frascella-dev/tdm-dash/design/index.html

Design proposal · milestone M1

# tdm-dash dashboard

The digital dashboard for the '92 Yamaha TDM 850, simulated at true 800×480 with the same measurements, the same filters and the same warnings that the Rust software will use. Use MODE and SET as on the bike.

- 7″ IPS
- 800×480 · 133 ppi
- 1000 cd/m²
- Pi Zero 2 W + Pico

MODE SET

## Riding layout

Classic Sport Touring

## Screen

On the bike: a short MODE changes screen, a long SET when stopped opens the settings.

## Scenario

Pause

×1 ×2 ×4

Turn the key (full restart)

## Ambient light

nighttunnelcloudysun

Auto Day Night

## Faults to try

Unplug the USB Freeze the app

They show the "fail-dark" behavior: better a black screen than stale data.

## Scale

Fit 1:1 pixel Real

"Real" shows the 154 × 86 mm of the active area on a 96 dpi screen.

M MODE · S SET (hold ≥ 1 s for a long press) · ← → turn signals · H high beam · 123 layout · Space pause

## Speed: true, measured and shown · last 12 s

- true
- measured by the Pico (windows over whole wheel revolutions)
- shown (filter, +3 % +1 km/h, hysteresis)

## Display

Model

Newhaven NHD-7.0-800480AF-ASXP

Diagonal

7″ · 133 ppi

Active area

154.2 × 85.6 mm

Outline

165 × 104 mm

Resolution

800 × 480, 18-bit RGB over DPI

Brightness

1000 cd/m², IPS

Temperature

−20 … +70 °C

Backlight

180 mA at 9.3 V · TPS61169, PWM from the Pico

Boot

< 4 s from key to first frame

## Rules for Slint

- No rotation except the needles, drawn as Paths with the points computed in Rust.
- Dials, glows and gradients pre-rendered at startup (tiny-skia) as opaque images.
- Rpm bars: pre-rendered image revealed by a clip rectangle.
- Digits in fixed-width cells: the numbers do not "jump" when they change.
- Sport speed ≥ 140 px high (≈ 27 mm on the 7″); daytime contrast ≥ 7:1.
- Warning lights in ECE colors: green turn signals and neutral, blue high beam, amber caution, red critical.
- No animations while riding, except warnings and the shift light.

## Palette

Typography: Saira Semi Condensed (OFL) for the dashboard digits and text.

Open-source project frascella-dev/tdm-dash (https://github.com/frascella-dev/tdm-dash) · design proposal for milestone M1 · the bike values are a draft until the bike measurements.
