frascella-dev/tdm-dash/hardware/exports/drawings/fit-template.pdf

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
A | A
B | B
C | C
D | D

SCALE
1:1

REV
0.2

DATE
2026-10-21

SIZE
A4

## Fit template

tdm-dash | mechanical parts · Yamaha TDM 850 (3VD) | CERN-OHL-P-2.0

github.com/frascella-dev/tdm-dash · generated by hardware/drawings/generate.py from hardware/enclosure/enclosure.scad, do not edit by hand

213.8

150

40

## FIT TEMPLATE · seen from the rider

cut along the thick line, pierce the two crosses

0 | 10 | 20 | 30 | 40 | 50 mm

Print at 100 % (actual size): this bar measures 50 mm

NOTES
1. Print at 100 %: the bar measures 50 mm and the width 213.8 mm. Glue on cardboard and cut along the thick line.
2. Hold it where the original cluster was, the face towards the rider. It must clear the windscreen, the inner fairing panels and the ignition key with the handlebar at full lock on both sides.
3. The crosses are the M6 studs of the mount plate: they must fall on the grommets of the fairing stay. If not, measure the grommets from the center lines and set stud_pitch, stud_x and stud_y in enclosure.scad.
4. Dashed: the pod and the mount plate, behind the display unit. Depth behind the face: 14.5 mm display unit, 65.6 mm with the pod, 68.6 mm with the plate.
