frascella-dev/tdm-dash/hardware/exports/drawings/sensor-bracket.pdf

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
A | A
B | B
C | C
D | D

SCALE
1:1

REV
0.2

DATE
2026-10-21

SIZE
A4

## Sensor bracket

tdm-dash | mechanical parts · Yamaha TDM 850 (3VD) | CERN-OHL-P-2.0

github.com/frascella-dev/tdm-dash · generated by hardware/drawings/generate.py from hardware/bracket/sensor-bracket.scad, do not edit by hand

83

48

8
35°

2× Ø10.5

slot 12.3 wide

3

Plate 3 mm, aluminum 5754 or 6082

0 | 10 | 20 | 30 | 40 | 50 mm

Print at 100 % (actual size): this bar measures 50 mm

NOTES
1. Print the PDF at 100 % (actual size) on A4 landscape and check the 50 mm bar.
2. Glue the print on the plate, center-punch the crossings of the center lines, drill the holes, then cut and file the outline.
3. Only aluminum may go under a brake caliper bolt. A printed bracket is a fit check, never a part (chapter 07).
4. The sensor slides in the slot: 48 ± 4 mm from the bolt. Its two M12 nuts set the 1–2 mm gap to the disc bolts.
5. Dimensions in mm, from sensor-bracket.scad. Orange values are [TO VERIFY] on the bike (docs/research/bike-measurements.md): set them in the .scad file and regenerate.
