frascella-dev/tdm-dash/design/screenshots/15-warm-up.png

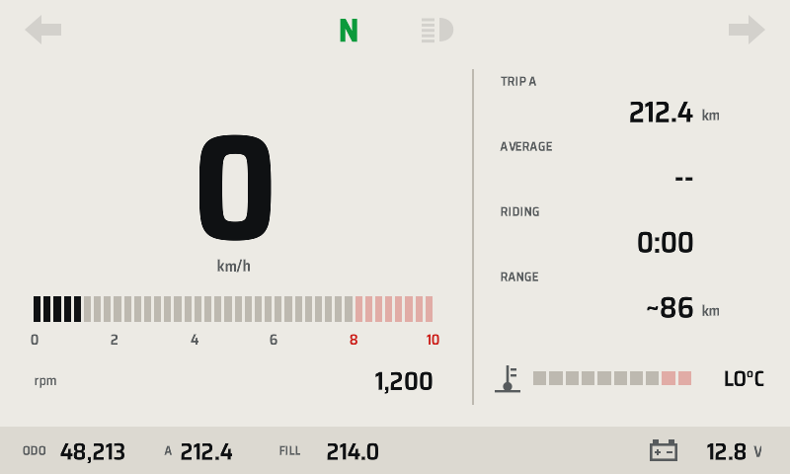
design/screenshots/15-warm-up.png
