frascella-dev/tdm-dash/design/screenshots/400x1280-r90/03-classic-day.png

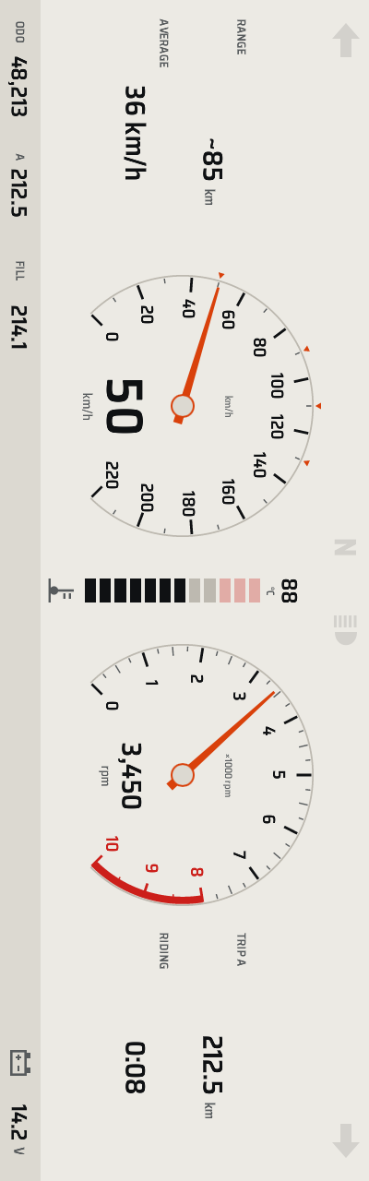
design/screenshots/400x1280-r90/03-classic-day.png
