frascella-dev/tdm-dash/design/screenshots/400x1280-r90/13-warning-critical.png

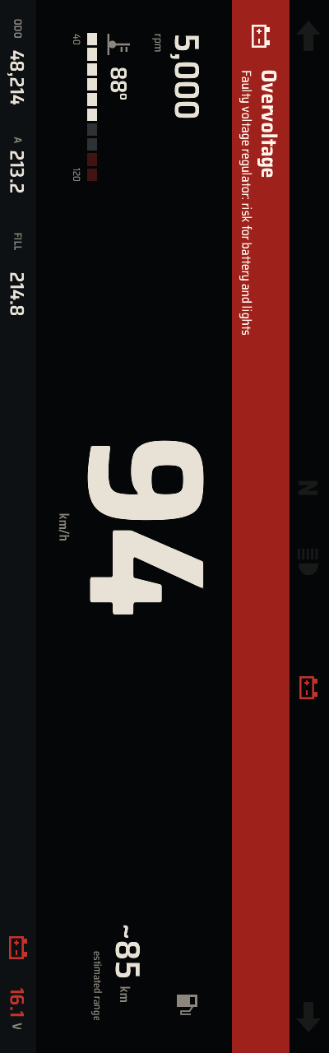
design/screenshots/400x1280-r90/13-warning-critical.png
