frascella-dev/tdm-dash/design/screenshots/1024x600/04-classic-night.png

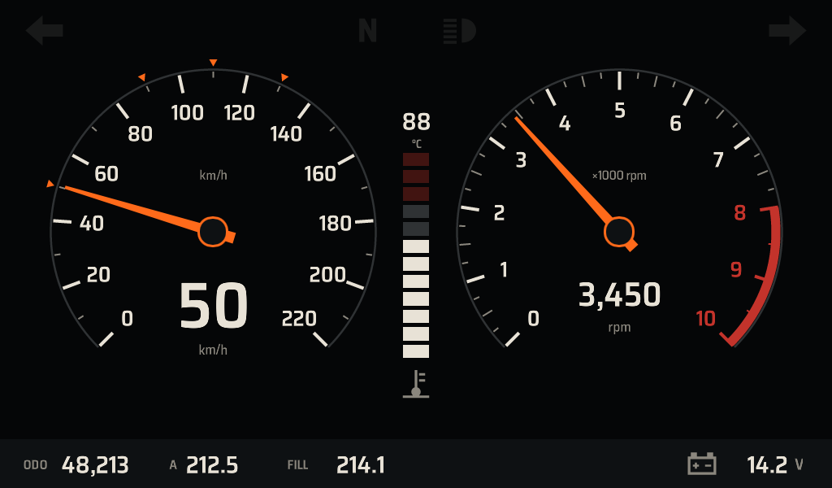
design/screenshots/1024x600/04-classic-night.png
