frascella-dev/tdm-dash/design/screenshots/1024x600/05-sport-day.png

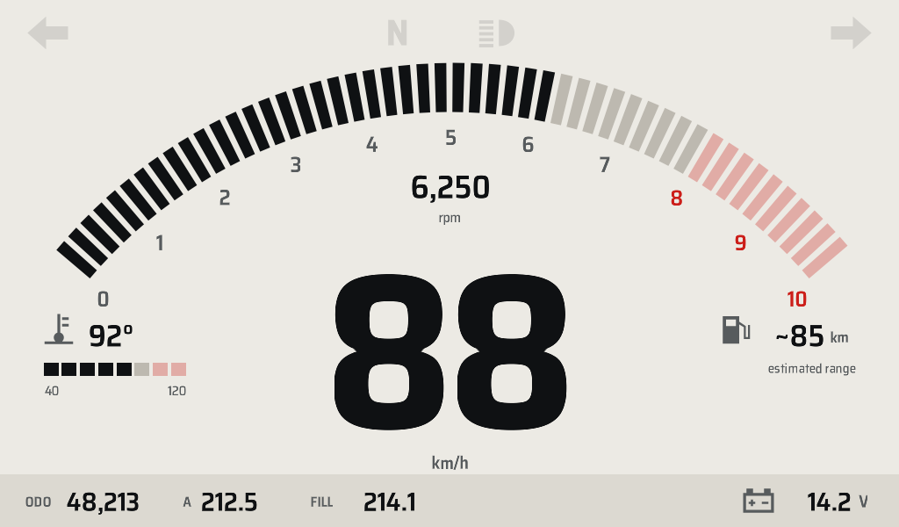
design/screenshots/1024x600/05-sport-day.png
