frascella-dev/tdm-dash/design/screenshots/1024x600/07-touring-day.png

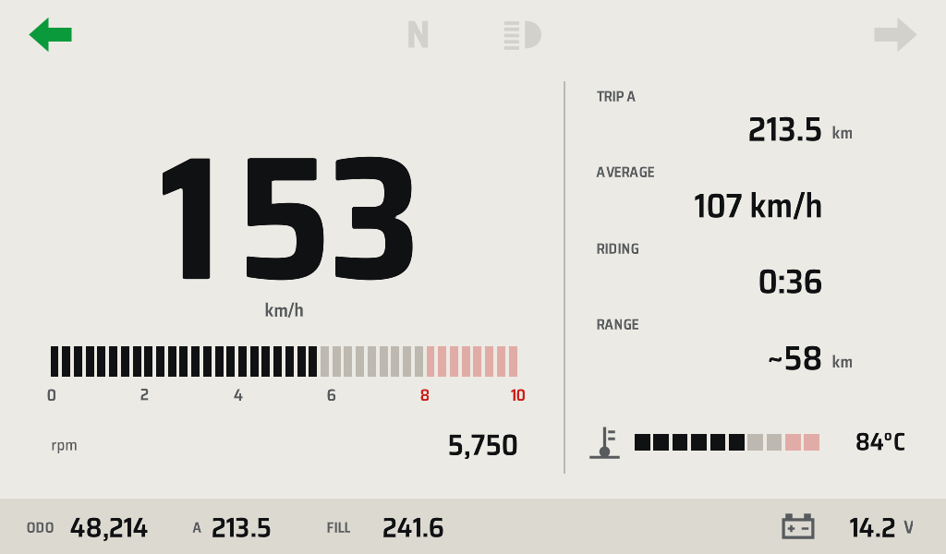
design/screenshots/1024x600/07-touring-day.png
