frascella-dev/tdm-dash/design/screenshots/1024x600/09-trip.png

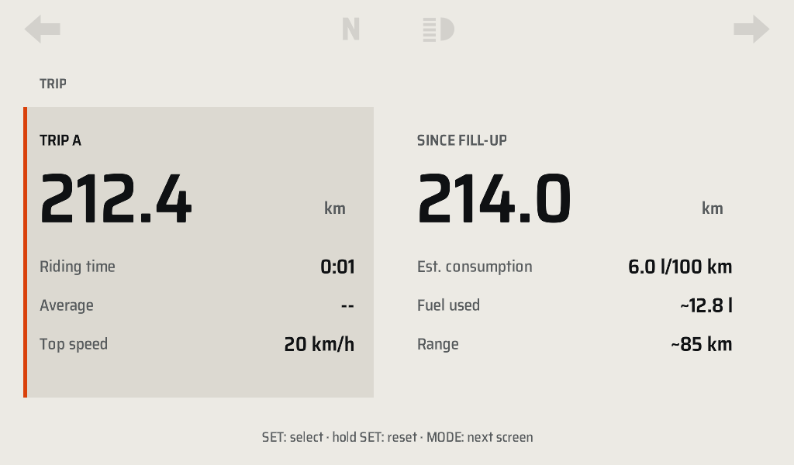
design/screenshots/1024x600/09-trip.png
