frascella-dev/tdm-dash/design/screenshots/1024x600/10-diagnostics.png

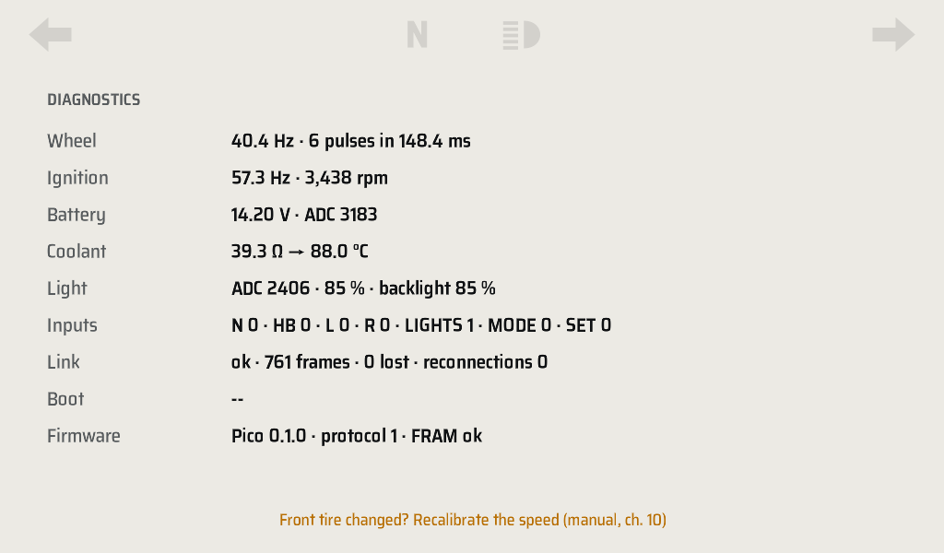
design/screenshots/1024x600/10-diagnostics.png
