frascella-dev/tdm-dash/design/screenshots/1024x600/11-settings.png

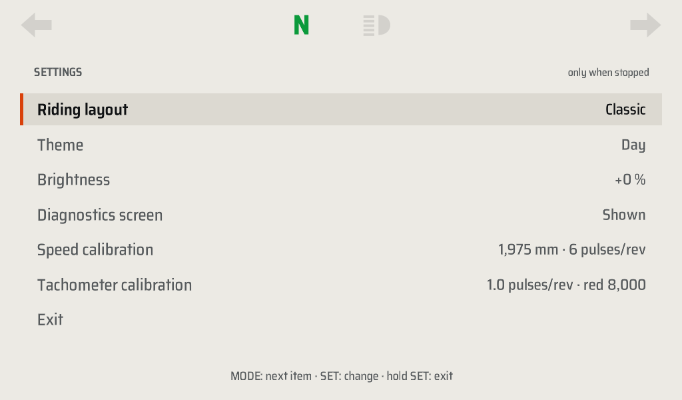
design/screenshots/1024x600/11-settings.png
