frascella-dev/tdm-dash/design/screenshots/1024x600/12-warning-caution.png

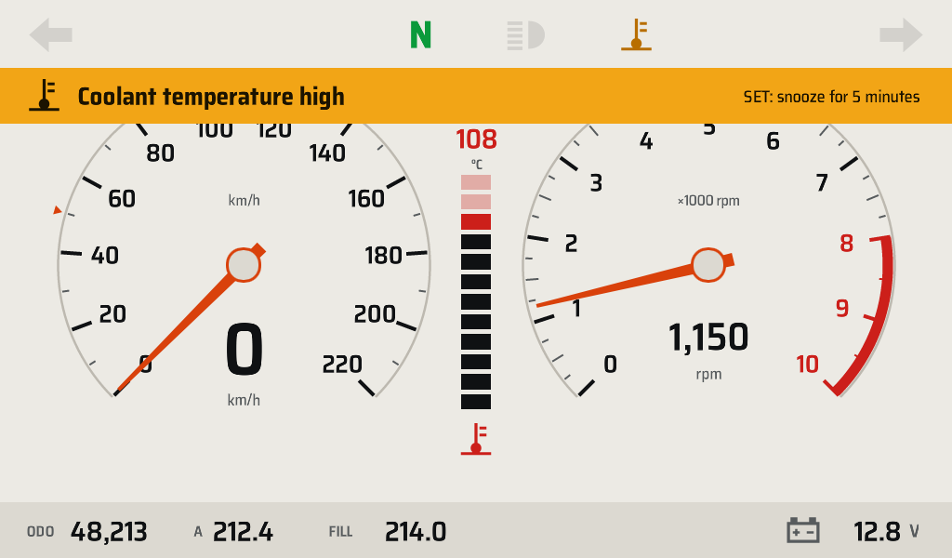
design/screenshots/1024x600/12-warning-caution.png
