frascella-dev/tdm-dash/design/screenshots/1024x600/13-warning-critical.png

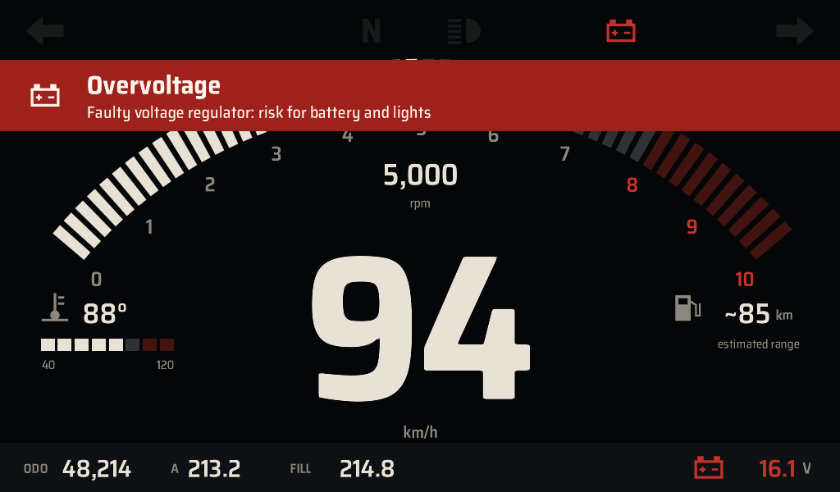
design/screenshots/1024x600/13-warning-critical.png
