frascella-dev/tdm-dash/design/screenshots/1280x400/03-classic-day.png

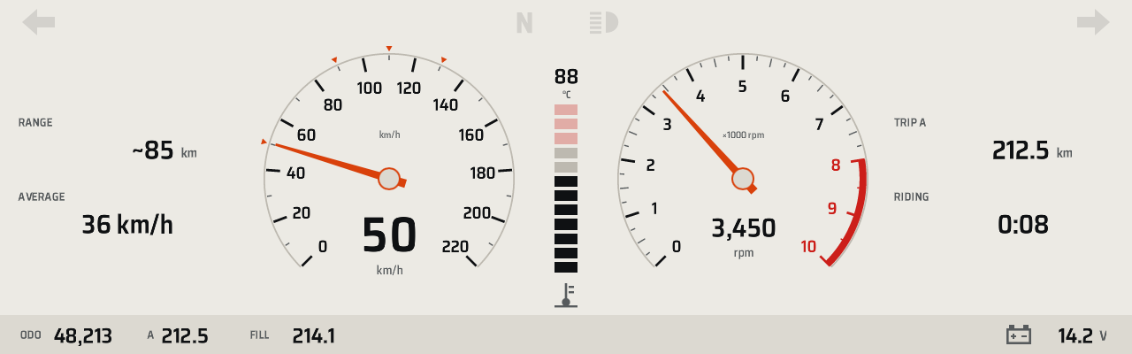
design/screenshots/1280x400/03-classic-day.png
