frascella-dev/tdm-dash/design/screenshots/1280x400/04-classic-night.png

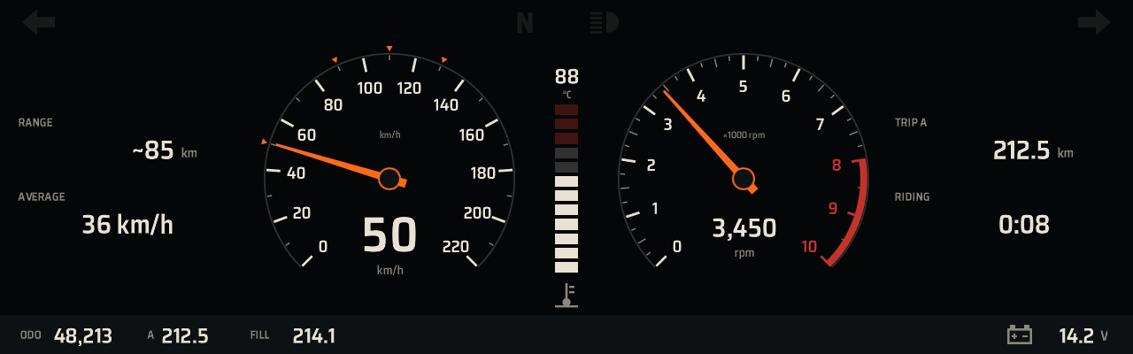
design/screenshots/1280x400/04-classic-night.png
