frascella-dev/tdm-dash/design/screenshots/1280x400/06-sport-night.png

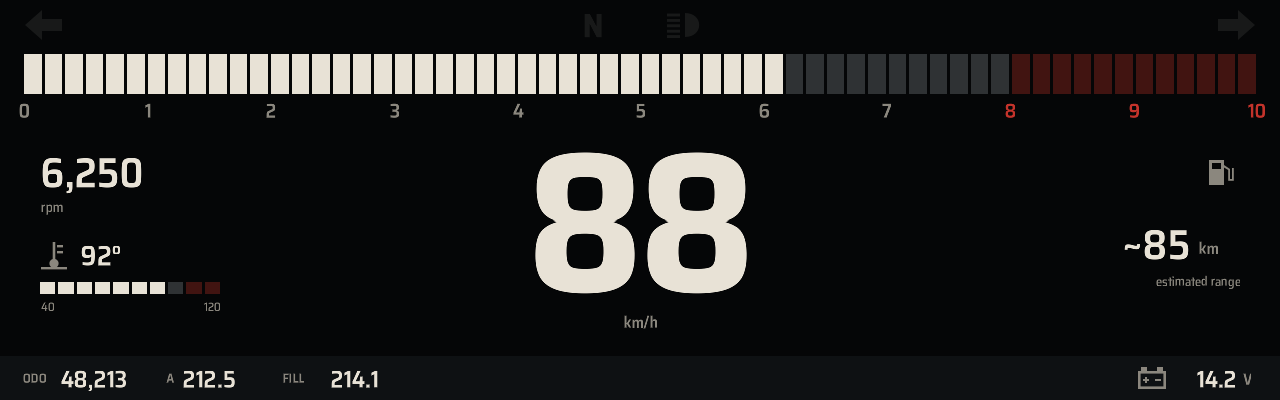
design/screenshots/1280x400/06-sport-night.png
