frascella-dev/tdm-dash/design/screenshots/1280x400/07-touring-day.png

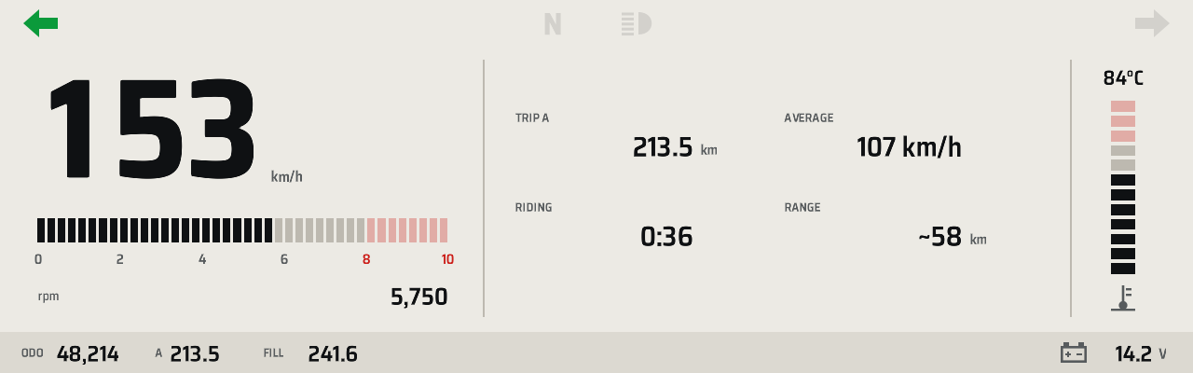
design/screenshots/1280x400/07-touring-day.png
