frascella-dev/tdm-dash/design/screenshots/1280x400/08-touring-night.png

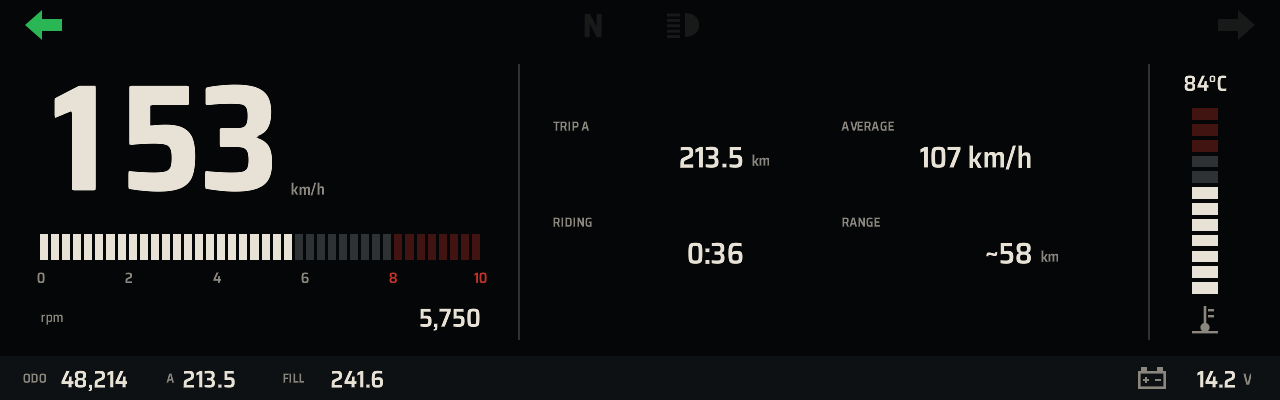
design/screenshots/1280x400/08-touring-night.png
