frascella-dev/tdm-dash/design/screenshots/1280x400/09-trip.png

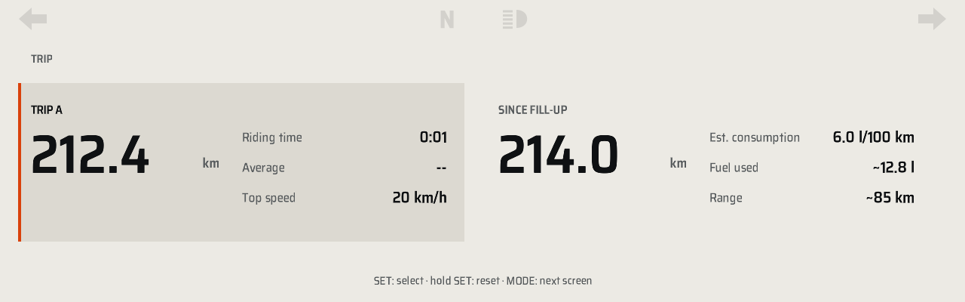
design/screenshots/1280x400/09-trip.png
