frascella-dev/tdm-dash/design/screenshots/1280x400/10-diagnostics.png

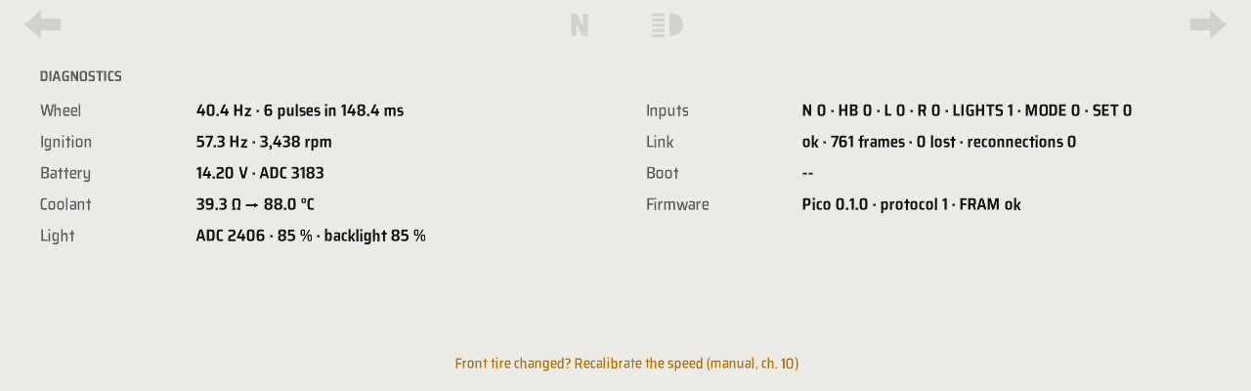
design/screenshots/1280x400/10-diagnostics.png
