frascella-dev/tdm-dash/design/screenshots/1280x400/11-settings.png

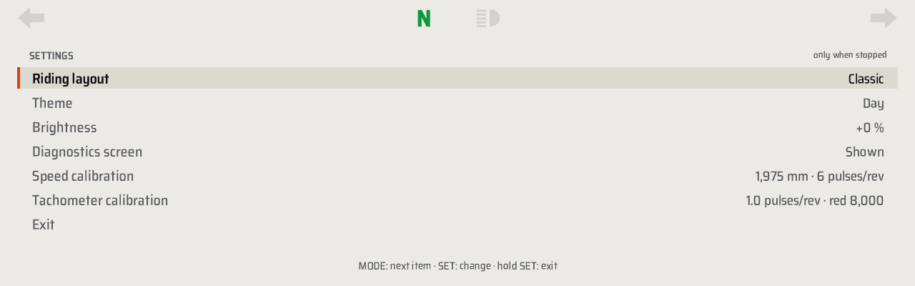
design/screenshots/1280x400/11-settings.png
