frascella-dev/tdm-dash/design/screenshots/1280x400/12-warning-caution.png

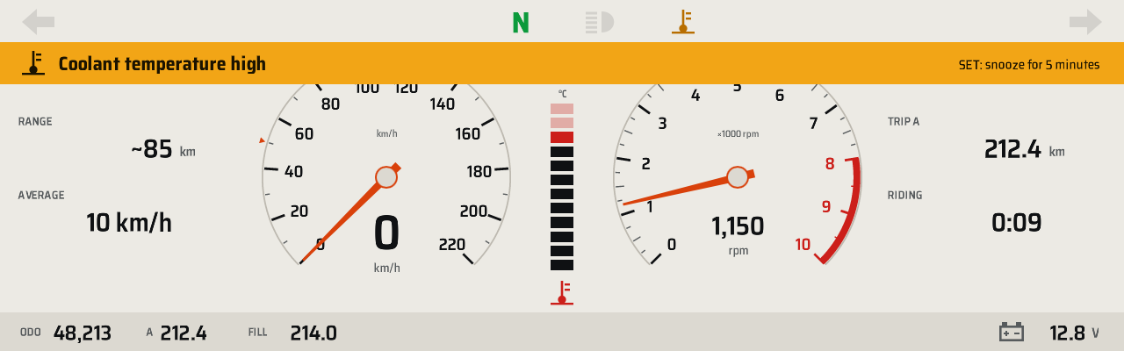
design/screenshots/1280x400/12-warning-caution.png
