frascella-dev/tdm-dash/design/screenshots/1280x400/13-warning-critical.png

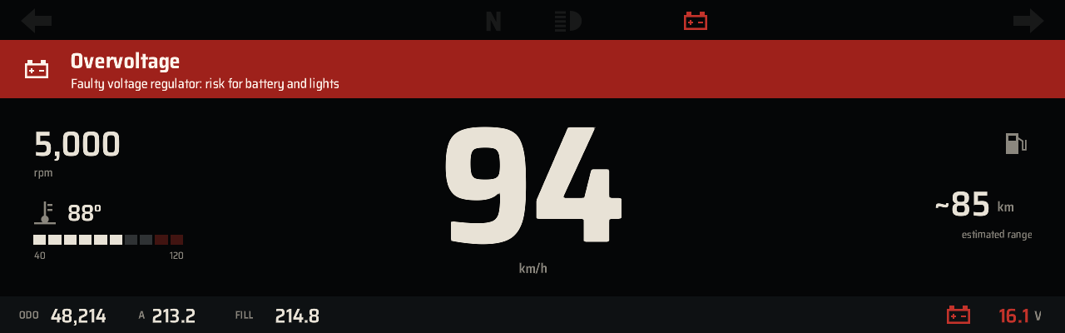
design/screenshots/1280x400/13-warning-critical.png
