frascella-dev/tdm-dash/design/screenshots/1280x400/14-usb-lost.png

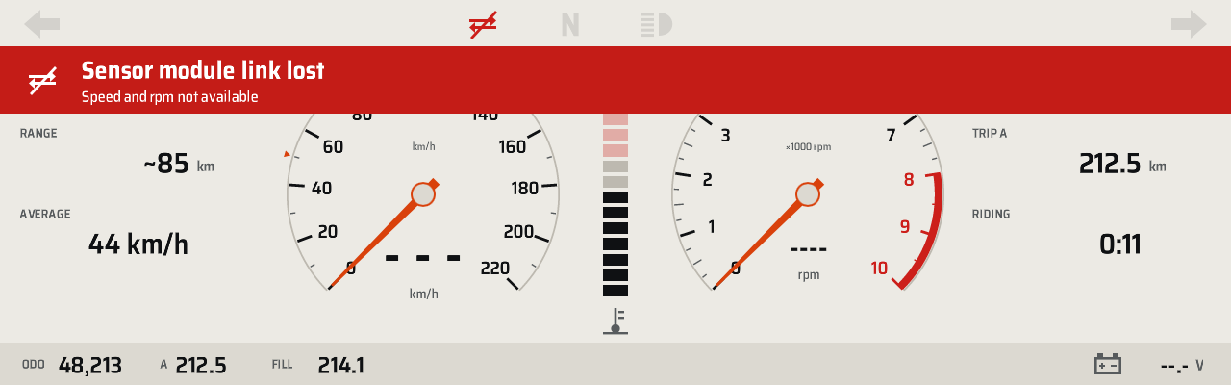
design/screenshots/1280x400/14-usb-lost.png
