frascella-dev/tdm-dash/design/screenshots/1280x720/03-classic-day.png

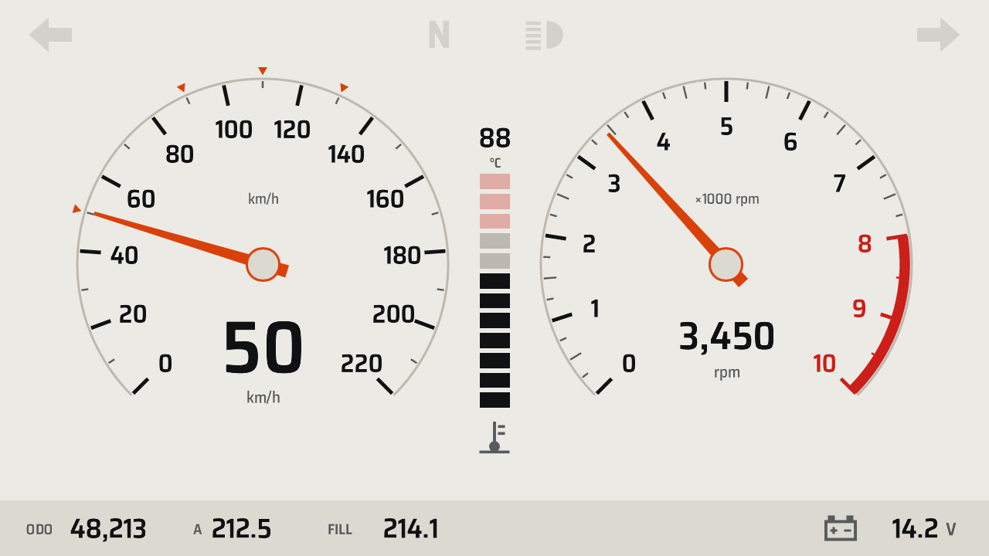
design/screenshots/1280x720/03-classic-day.png
