frascella-dev/tdm-dash/design/screenshots/1280x720/05-sport-day.png

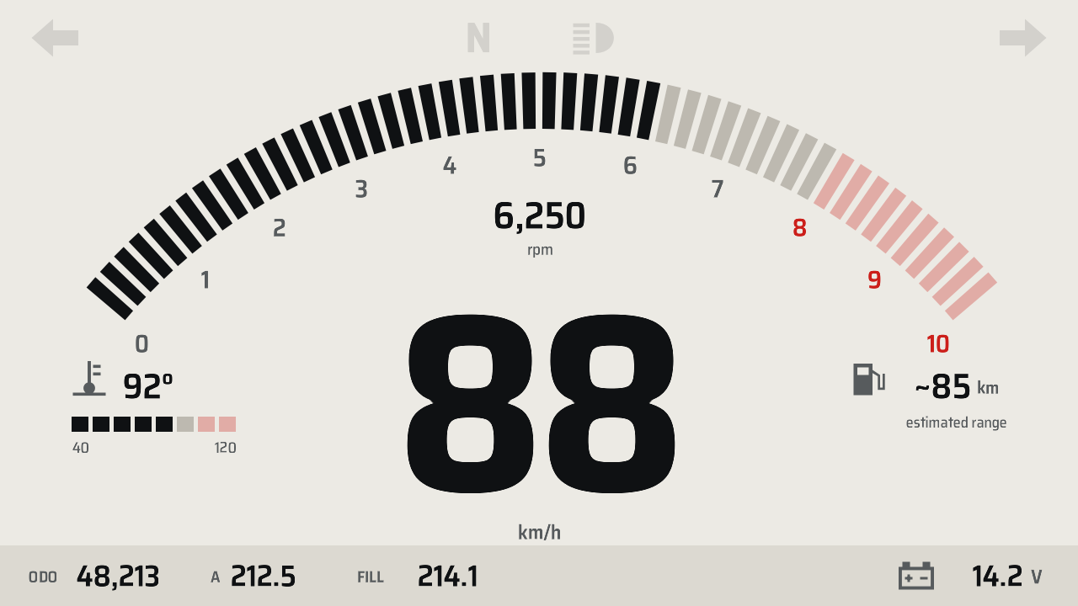
design/screenshots/1280x720/05-sport-day.png
