frascella-dev/tdm-dash/design/screenshots/1280x720/07-touring-day.png

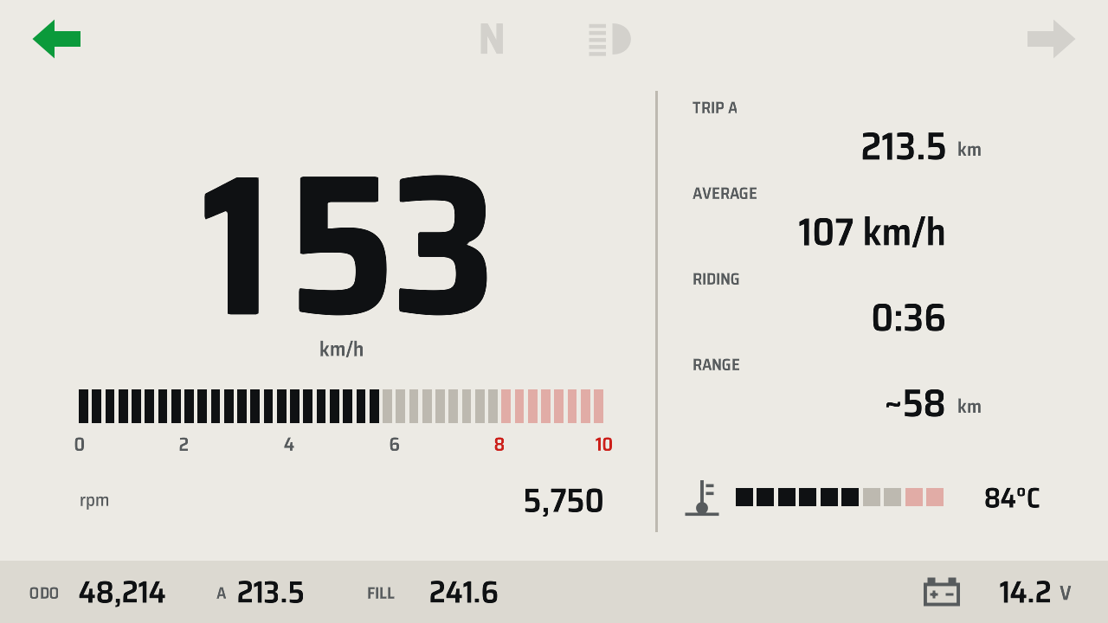
design/screenshots/1280x720/07-touring-day.png
