frascella-dev/tdm-dash/design/screenshots/1280x720/10-diagnostics.png

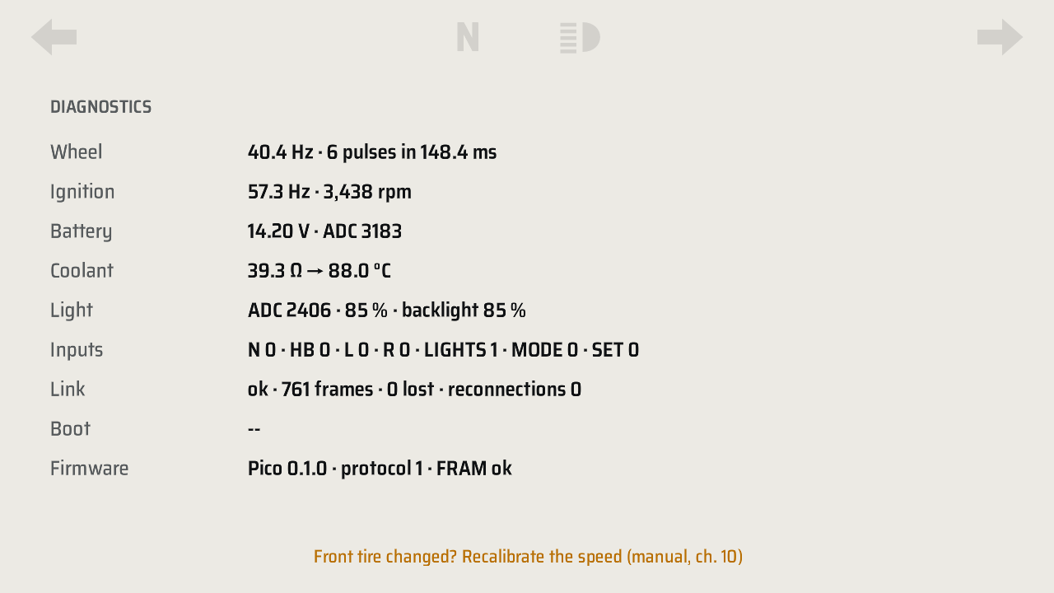
design/screenshots/1280x720/10-diagnostics.png
