frascella-dev/tdm-dash/design/screenshots/1920x480/03-classic-day.png

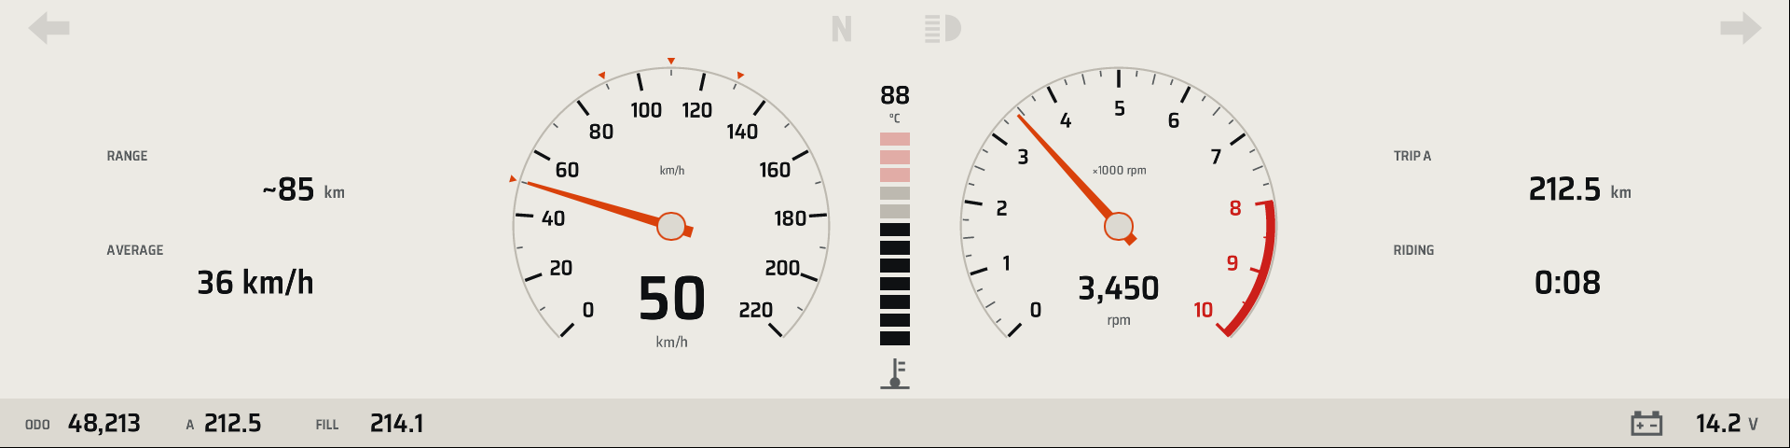
design/screenshots/1920x480/03-classic-day.png
