frascella-dev/tdm-dash/design/screenshots/1920x480/04-classic-night.png

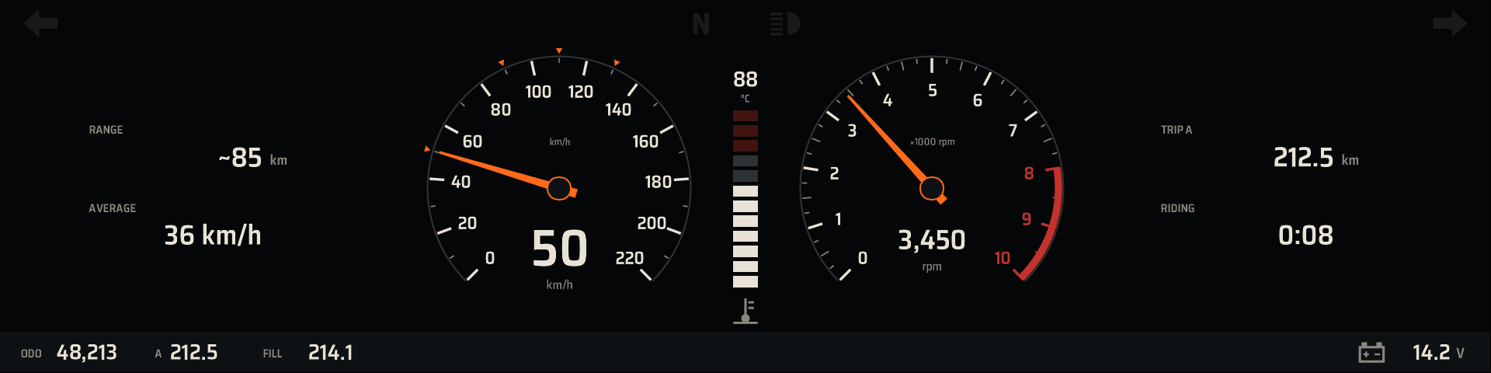
design/screenshots/1920x480/04-classic-night.png
