frascella-dev/tdm-dash/design/screenshots/1920x480/07-touring-day.png

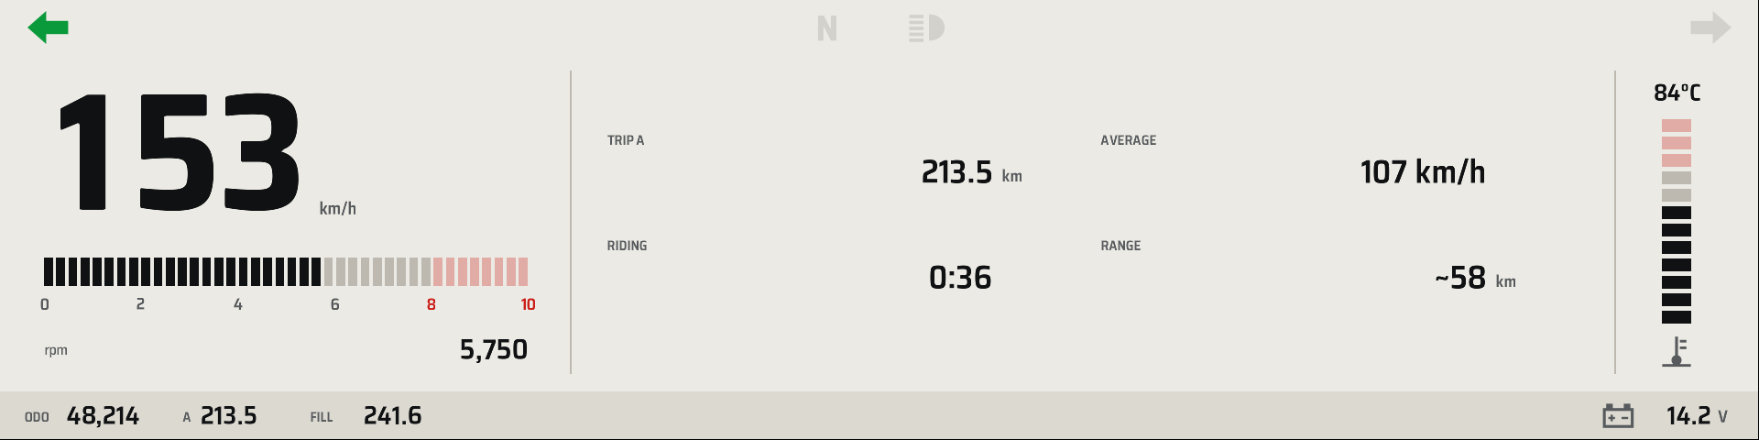
design/screenshots/1920x480/07-touring-day.png
