frascella-dev/tdm-dash/design/screenshots/1920x480/10-diagnostics.png

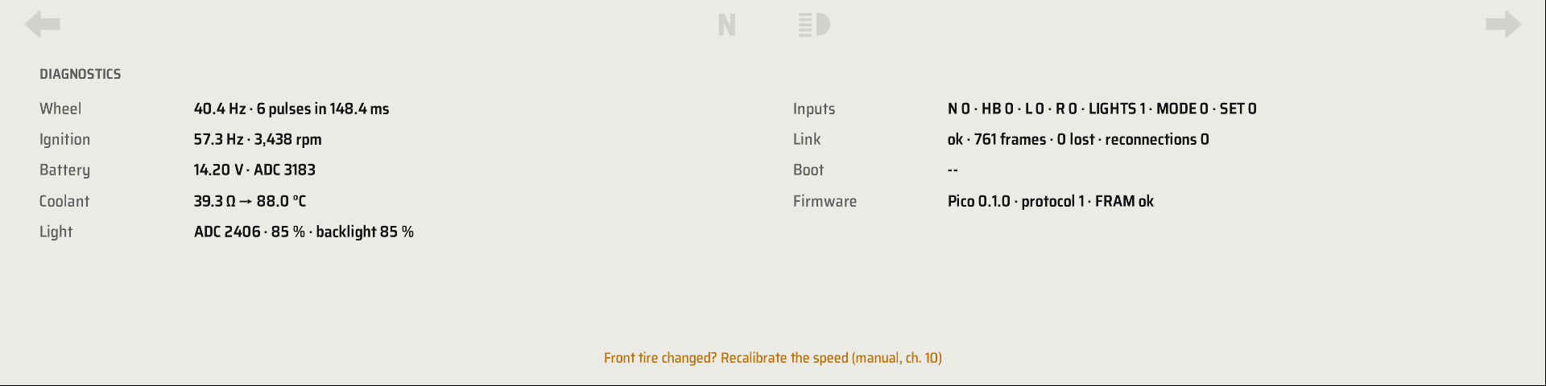
design/screenshots/1920x480/10-diagnostics.png
