frascella-dev/tdm-dash/design/screenshots/1920x720/03-classic-day.png

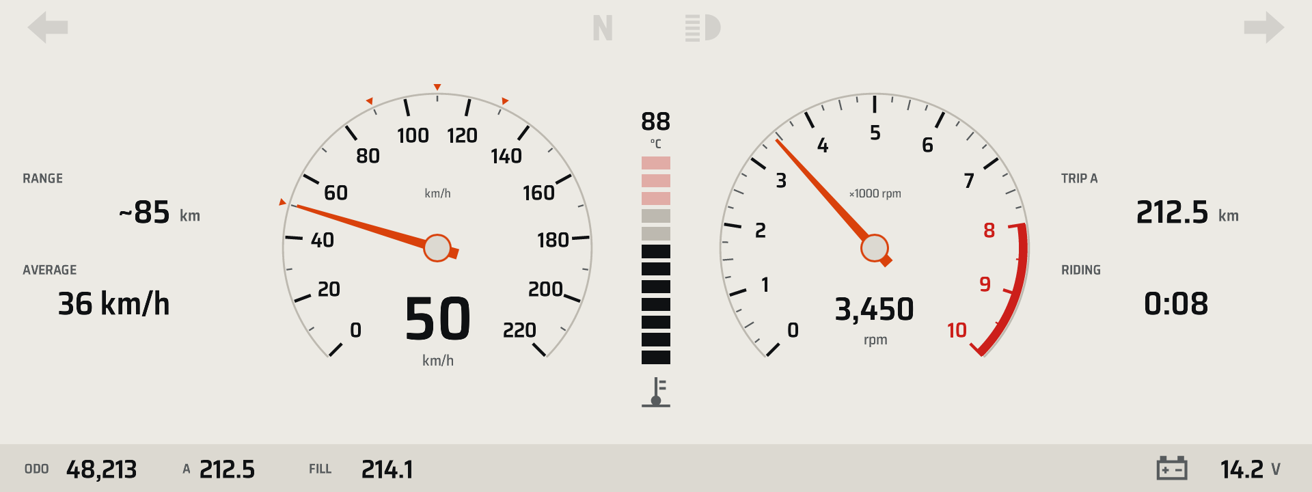
design/screenshots/1920x720/03-classic-day.png
