frascella-dev/tdm-dash/design/screenshots/1920x720/04-classic-night.png

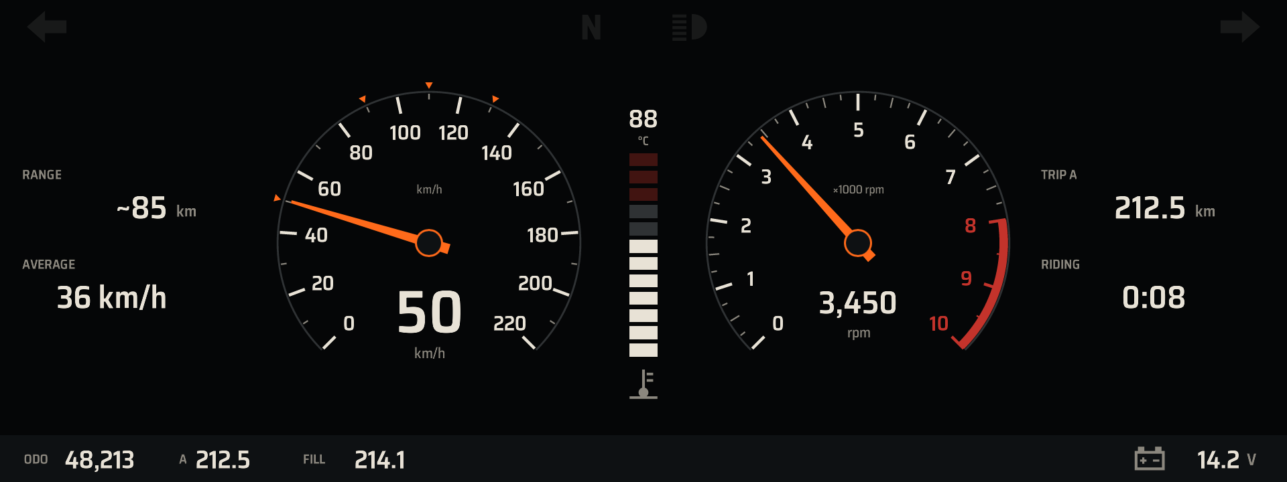
design/screenshots/1920x720/04-classic-night.png
