frascella-dev/tdm-dash/design/screenshots/1920x720/12-warning-caution.png

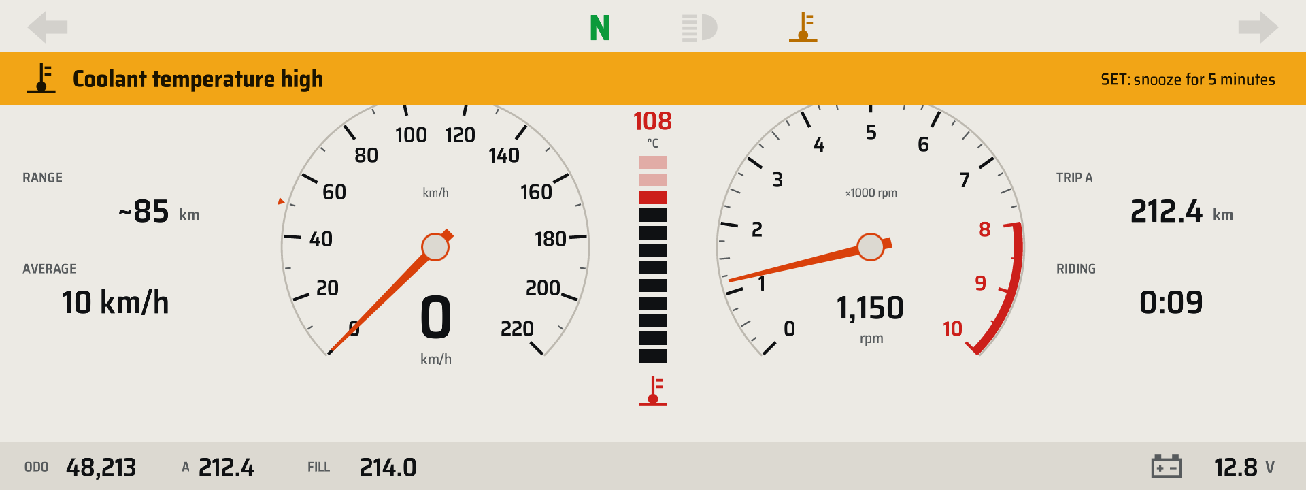
design/screenshots/1920x720/12-warning-caution.png
