frascella-dev/tdm-dash/design/screenshots/it-07-touring-day.png

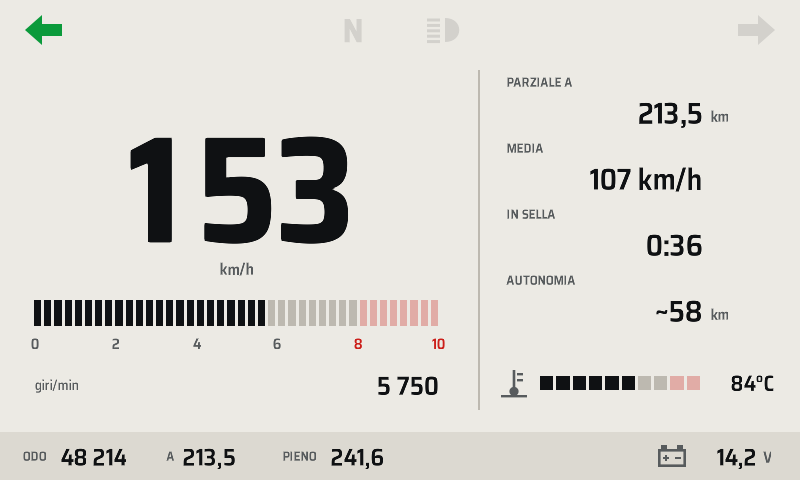
design/screenshots/it-07-touring-day.png
