frascella-dev/tdm-dash/design/screenshots/it-09-trip.png

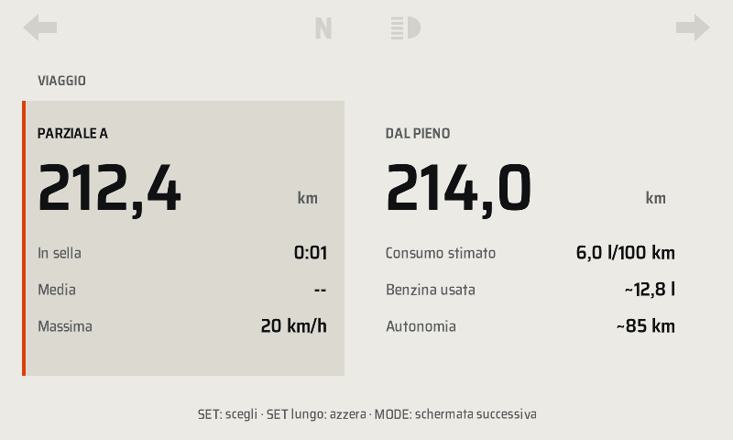
design/screenshots/it-09-trip.png
