frascella-dev/tdm-dash/design/screenshots/it-10-diagnostics.png

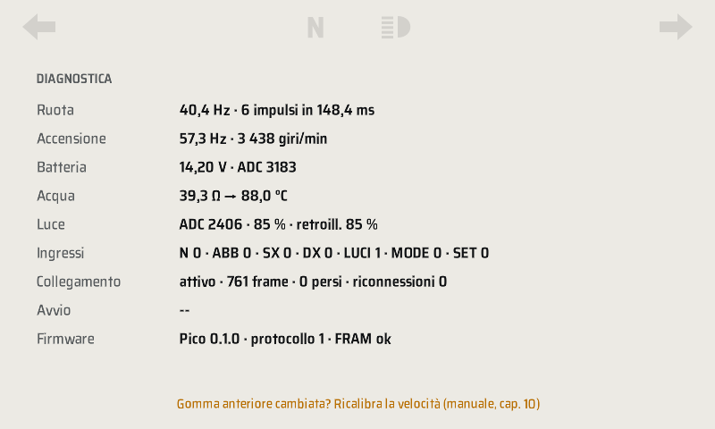
design/screenshots/it-10-diagnostics.png
