frascella-dev/tdm-dash/design/screenshots/it-11-settings.png

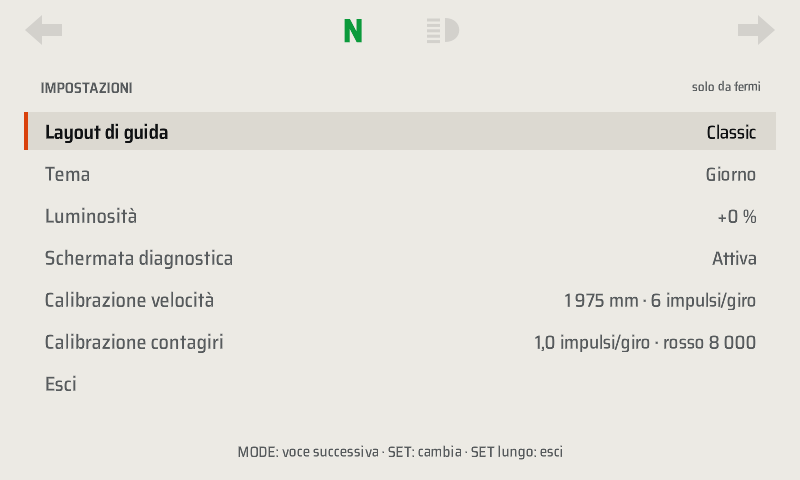
design/screenshots/it-11-settings.png
