frascella-dev/tdm-dash/hardware/exports/harness/backlight.bom.tsv

Id | Description | Qty | Unit | Designators
1 | Cable, Lead, 3 x 0.25 mm² | 0.15 | m | W1
2 | Cable, Pair, 2 x 0.25 mm² | 0.1 | m | W2
3 | Connector, Panel backlight LEDs, on the Kippah [TO VERIFY], 2 pins | 1 |  | J704
4 | Connector, TPS61169 breakout, pin order [TO VERIFY], 5 pins | 1 |  | U701
5 | Connector, Terminal on the perfboard, 3 pins | 1 |  | J701
