frascella-dev/tdm-dash/hardware/exports/harness/panel.bom.tsv

Id | Description | Qty | Unit | Designators
1 | Cable, Lead, 3 x 0.14 mm² | 0.1 | m | W2
2 | Cable, Lead, 4 x 0.25 mm² | 0.15 | m | W1
3 | Connector, IP67 push button, MODE, momentary NO, 2 pins | 1 |  | SW601
4 | Connector, IP67 push button, SET, momentary NO, 2 pins | 1 |  | SW602
5 | Connector, TEMT6000 (breakout), behind the light hole, 3 pins | 1 |  | U1
6 | Connector, Terminal on the perfboard, 3 pins | 2 |  | J501, J601
