frascella-dev/tdm-dash/hardware/exports/harness/wheel-sensor.bom.tsv

Id | Description | Qty | Unit | Designators
1 | Cable, Sensor cable, 3 x 0.34 mm² | 1 | m | W1
2 | Cable, Shielded 3-core cable, 3 x 0.34 mm² shielded | 1.2 | m | W2
3 | Connector, Deutsch DTM04-3P, male, mates X2, 3 pins | 1 |  | X1
4 | Connector, Deutsch DTM06-3S + W3S, female, mates X1, 3 pins | 1 |  | X2
5 | Connector, LJ12A3-4-Z/BX, inductive NPN NO, 6–36 V, 3 pins | 1 |  | S1
6 | Connector, Terminal on the perfboard, 3 pins | 1 |  | J401
