frascella-dev/tdm-dash/hardware/exports/cad/dash-mount.stl

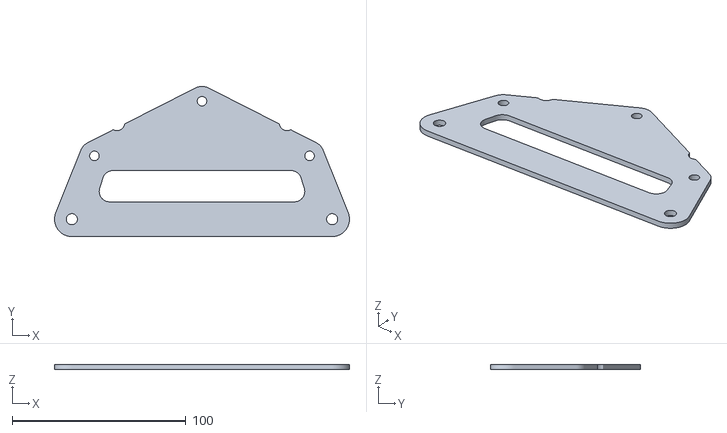
[picture p49: CAD file, 2026-10-21]
hardware/exports/cad/dash-mount.stl
170.0 x 86.5 x 3.00
