frascella-dev/tdm-dash/hardware/exports/cad/enclosure-front.stl

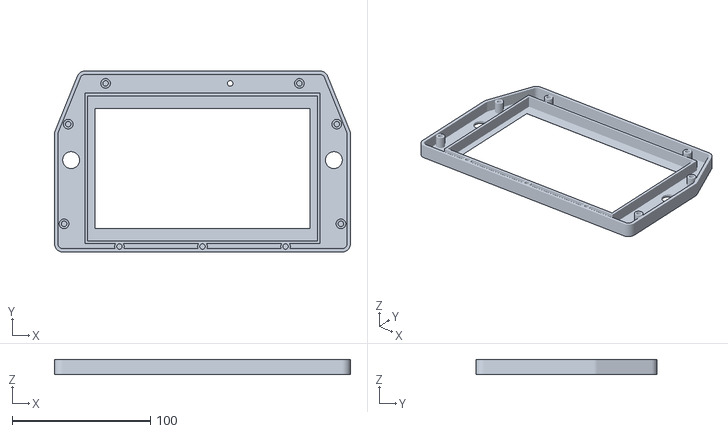
[picture p50: CAD file, 2026-10-21]
hardware/exports/cad/enclosure-front.stl
213.8 x 130.8 x 11.0
