frascella-dev/tdm-dash/hardware/exports/cad/enclosure-rear.stl

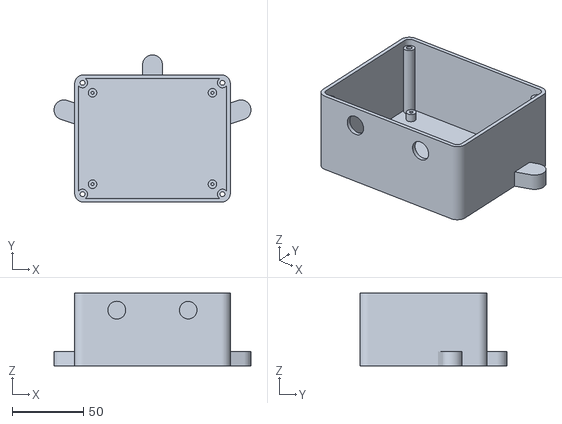
[picture p51: CAD file, 2026-10-21]
hardware/exports/cad/enclosure-rear.stl
138.0 x 103.0 x 51.1
