frascella-dev/tdm-dash/hardware/exports/cad/enclosure-cover.stl

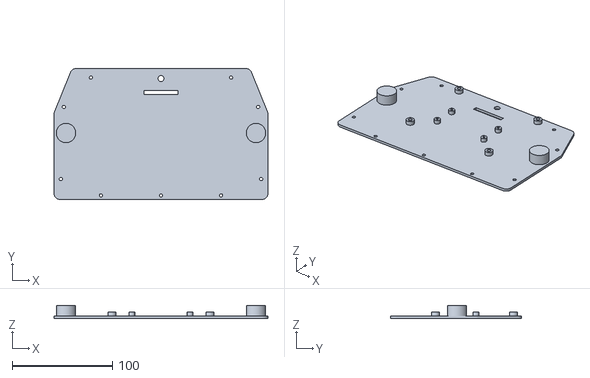
[picture p52: CAD file, 2026-10-21]
hardware/exports/cad/enclosure-cover.stl
213.8 x 130.8 x 13.0
