frascella-dev/tdm-dash/hardware/exports/cad/sensor-bracket.stl

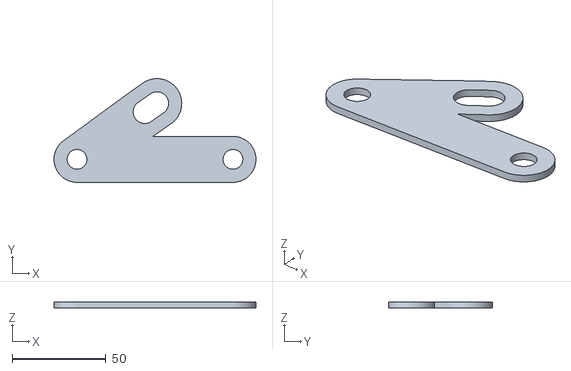
[picture p53: CAD file, 2026-10-21]
hardware/exports/cad/sensor-bracket.stl
107.5 x 55.2 x 3.00
