frascella-dev/tdm-dash/(list of files, cad)

Other CAD files:
hardware/exports/cad/dash-mount.dxf
hardware/exports/cad/sensor-bracket.dxf
