frascella-dev/tdm-dash/hardware/exports/drawings/dash-mount.pdf

124

4× R4.5

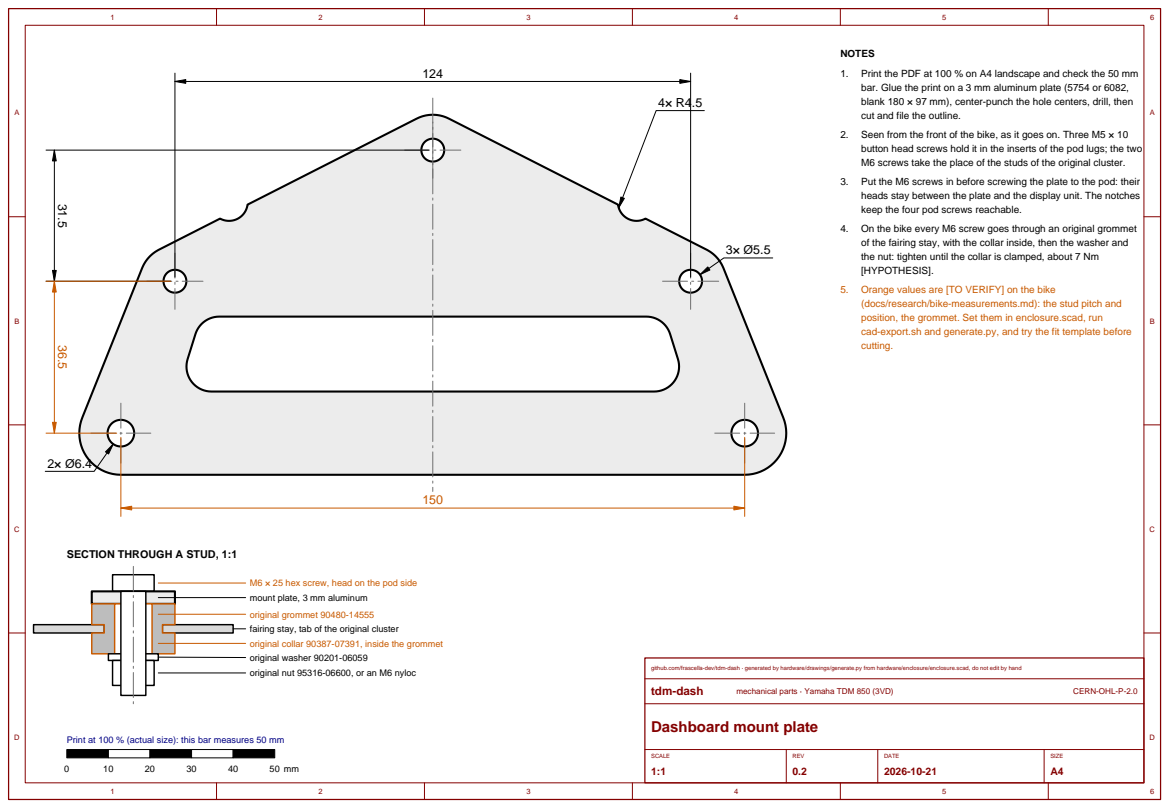
[picture p71: page 1]
SCALE 1:1; REV 0.2; DATE 2026-10-21; SIZE A4; tdm-dash; mechanical parts · Yamaha TDM 850 (3VD); CERN-OHL-P-2.0

NOTES
1. Print the PDF at 100 % on A4 landscape and check the 50 mm
bar. Glue the print on a 3 mm aluminum plate (5754 or 6082,
blank 180 × 97 mm), center-punch the hole centers, drill, then
cut and file the outline.
2. Seen from the front of the bike, as it goes on. Three M5 × 10
button head screws hold it in the inserts of the pod lugs; the two
M6 screws take the place of the studs of the original cluster.
3. Put the M6 screws in before screwing the plate to the pod: their
heads stay between the plate and the display unit. The notches
keep the four pod screws reachable.
4. On the bike every M6 screw goes through an original grommet
of the fairing stay, with the collar inside, then the washer and
the nut: tighten until the collar is clamped, about 7 Nm
[HYPOTHESIS].
5. Orange values are [TO VERIFY] on the bike
(docs/research/bike-measurements.md): the stud pitch and
position, the grommet. Set them in enclosure.scad, run
cad-export.sh and generate.py, and try the fit template before
cutting.

SECTION THROUGH A STUD, 1:1

M6 × 25 hex screw, head on the pod side
mount plate, 3 mm aluminum
original grommet 90480-14555
fairing stay, tab of the original cluster
original collar 90387-07391, inside the grommet
original washer 90201-06059
original nut 95316-06600, or an M6 nyloc

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

Dashboard mount plate

Print at 100 % (actual size): this bar measures 50 mm
