frascella-dev/tdm-dash/hardware/exports/drawings/enclosure.pdf

213.8

### window 159.2

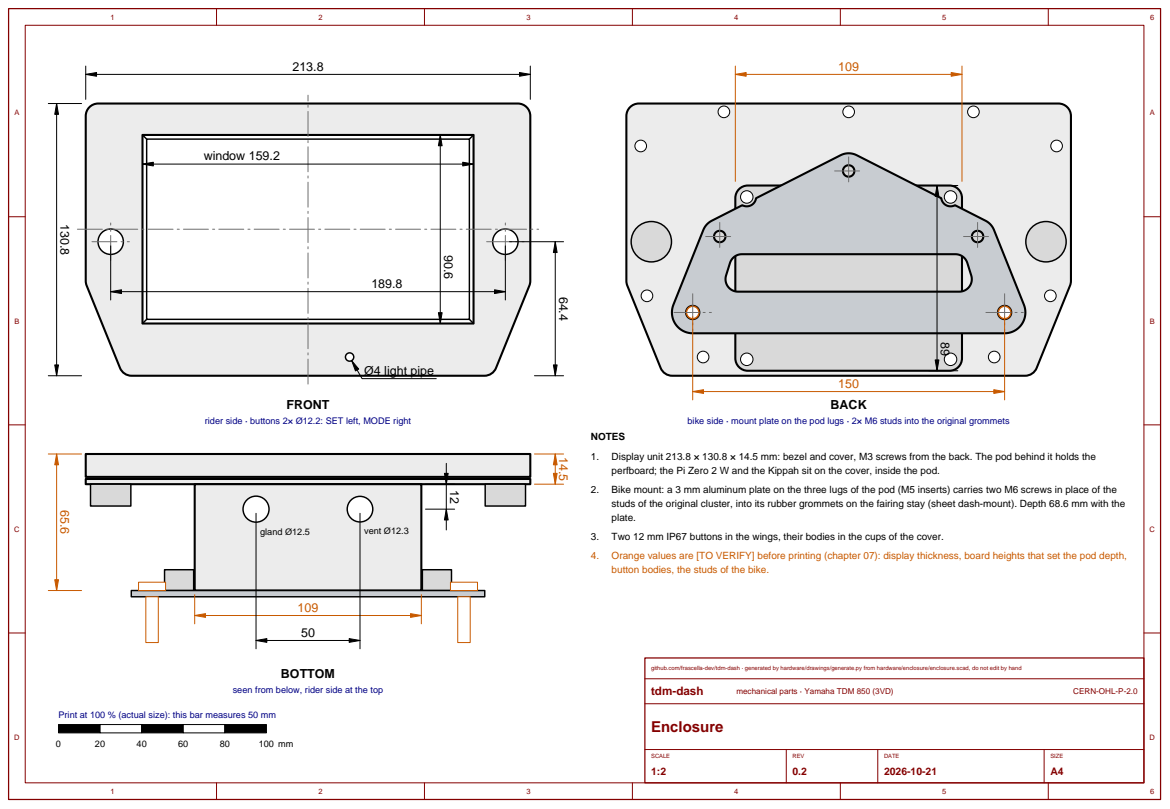
[picture p72: page 1]
SCALE 1:2; REV 0.2; DATE 2026-10-21; SIZE A4; Enclosure; tdm-dash; mechanical parts · Yamaha TDM 850 (3VD); CERN-OHL-P-2.0; Ø4 light pipe; FRONT; BACK; gland Ø12.5; vent Ø12.3; BOTTOM

rider side · buttons 2× Ø12.2: SET left, MODE right

bike side · mount plate on the pod lugs · 2× M6 studs into the original grommets

NOTES
1. Display unit 213.8 × 130.8 × 14.5 mm: bezel and cover, M3 screws from the back. The pod behind it holds the
perfboard; the Pi Zero 2 W and the Kippah sit on the cover, inside the pod.
2. Bike mount: a 3 mm aluminum plate on the three lugs of the pod (M5 inserts) carries two M6 screws in place of the
studs of the original cluster, into its rubber grommets on the fairing stay (sheet dash-mount). Depth 68.6 mm with the
plate.
3. Two 12 mm IP67 buttons in the wings, their bodies in the cups of the cover.
4. Orange values are [TO VERIFY] before printing (chapter 07): display thickness, board heights that set the pod depth,
button bodies, the studs of the bike.

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

seen from below, rider side at the top

Print at 100 % (actual size): this bar measures 50 mm
