frascella-dev/tdm-dash/hardware/exports/kicad/tdm-dash.pdf

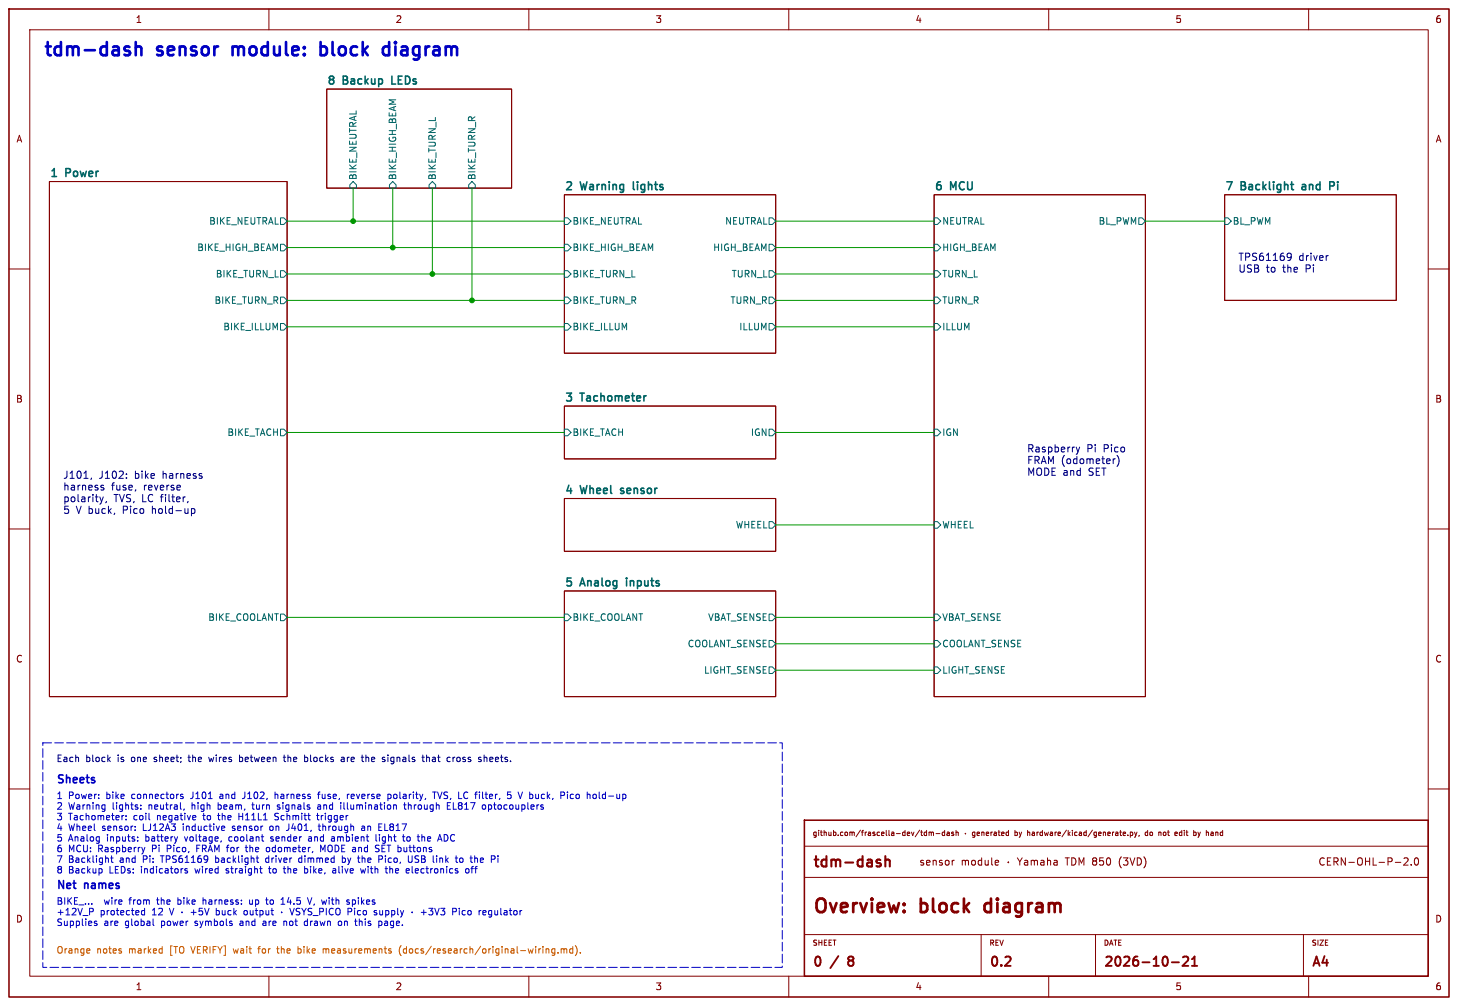
[picture p74: page 1]

TPS61169 driver USB to the Pi

Raspberry Pi Pico FRAM (odometer) MODE and SET

J101, J102: bike harness harness fuse, reverse

Each block is one sheet; the wires between the blocks are the signals that cross sheets.
Sheets

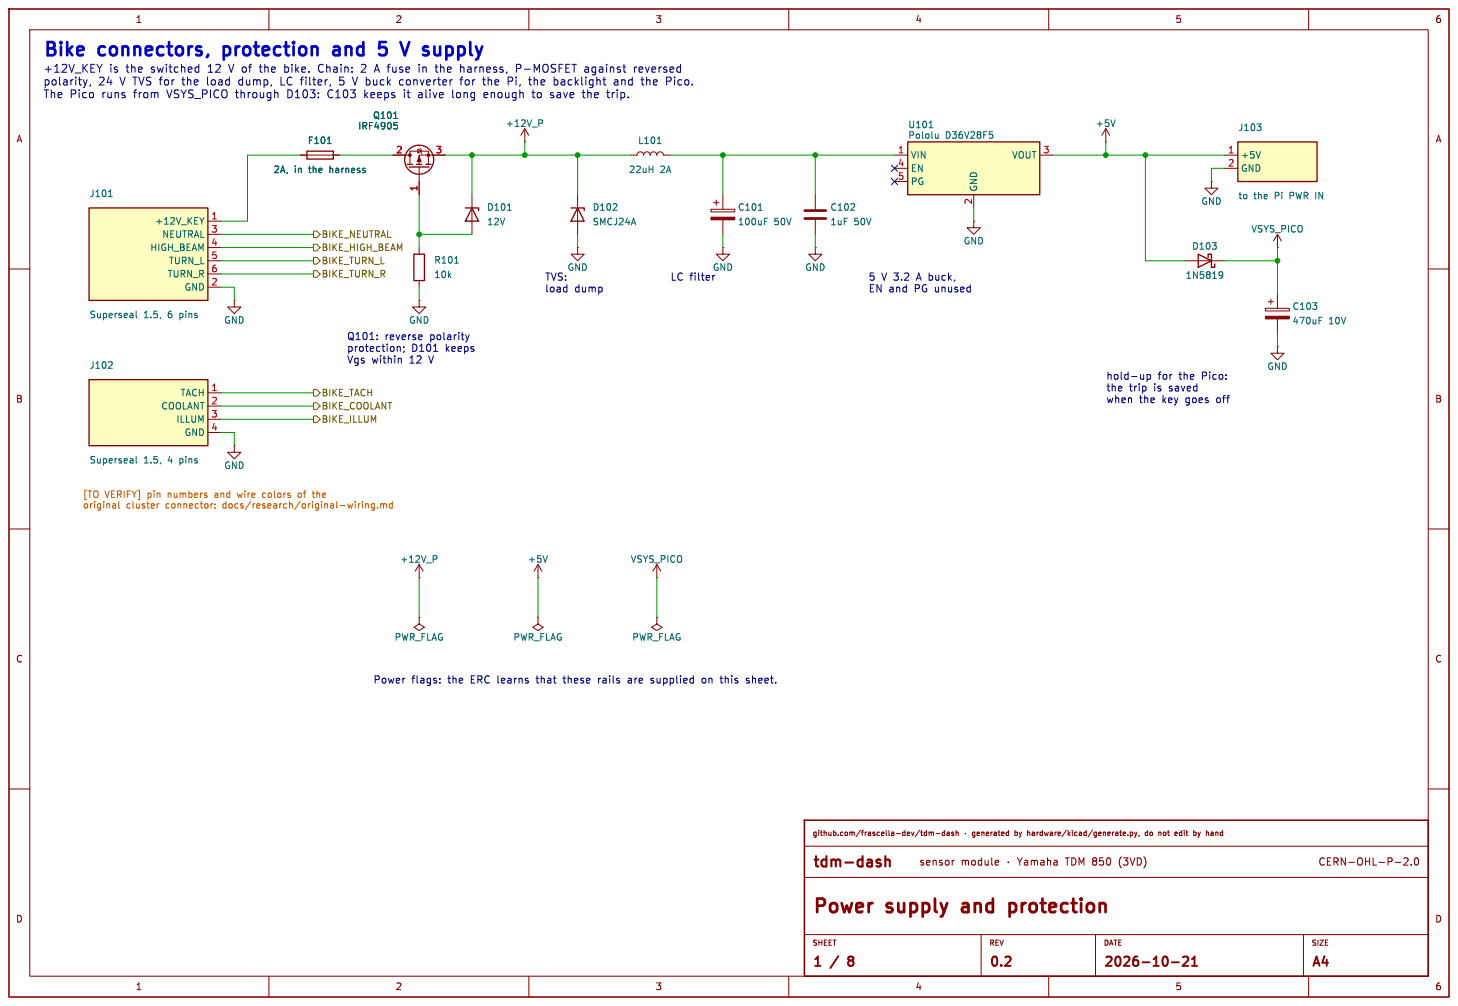
[picture p75: page 2]

Bike connectors, protection and 5 V supply
+12V_KEY is the switched 12 V of the bike. Chain: 2 A fuse in the harness, P-MOSFET against reversed

to the Pi PWR IN GND

the trip is saved when the key goes off TVS:
load dump

[TO VERIFY] pin numbers and wire colors of the

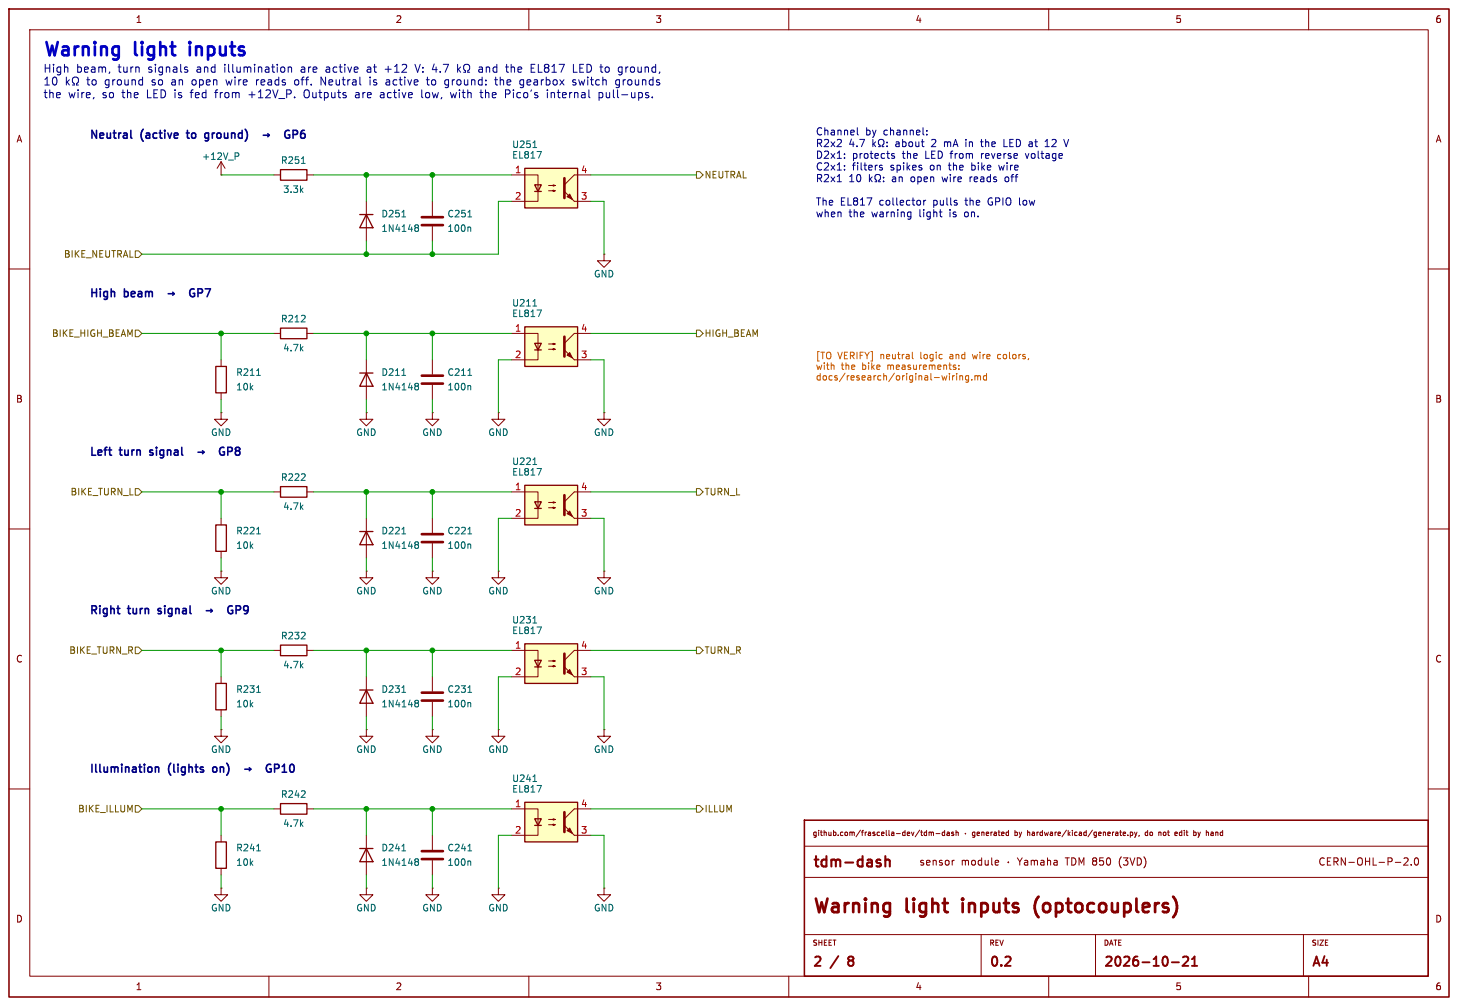
[picture p76: page 3]

when the warning light is on.

[TO VERIFY] neutral logic and wire colors, with the bike measurements: docs/research/original-wiring.md

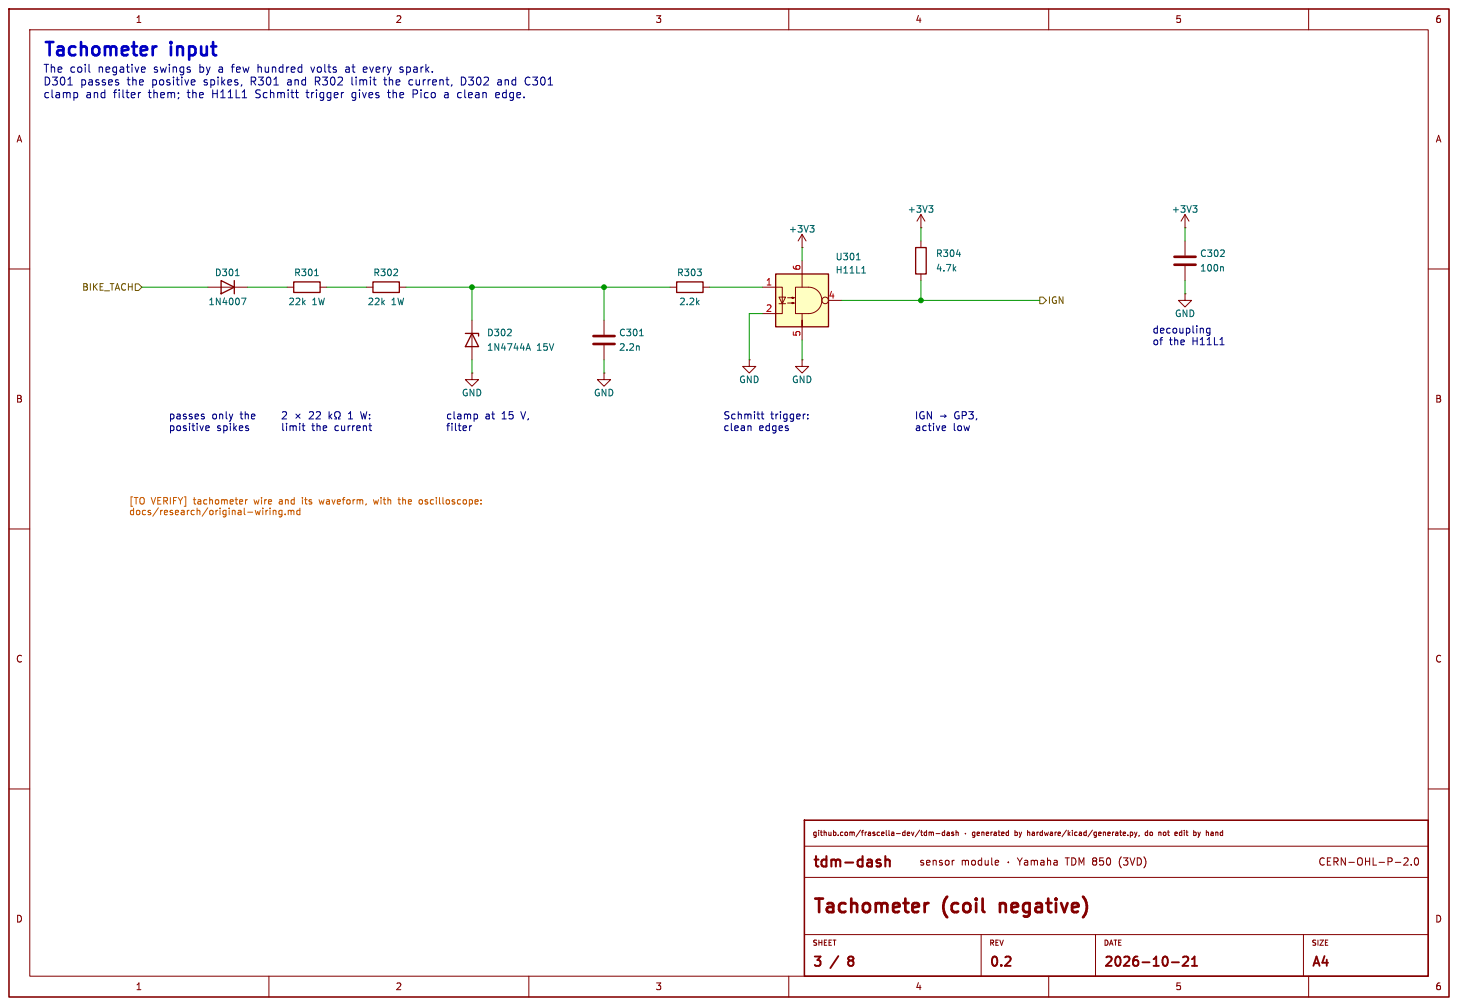
[picture p77: page 4]

of the H11L1 Schmitt trigger: clean edges

IGN þÿ!’GP3, active low

docs/research/original-wiring.md

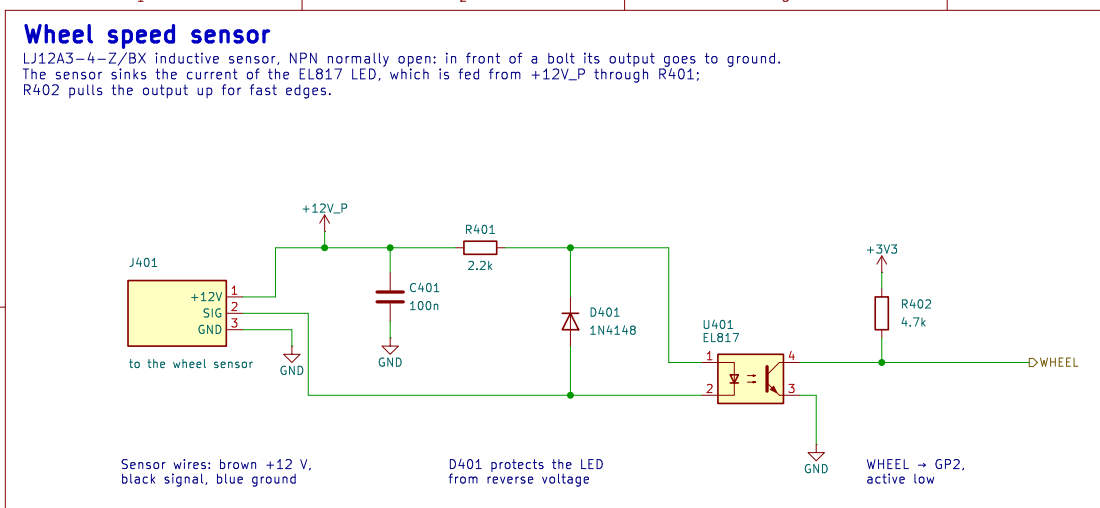
[picture p78: page 5]

Sensor wires: brown +12 V, black signal, blue ground

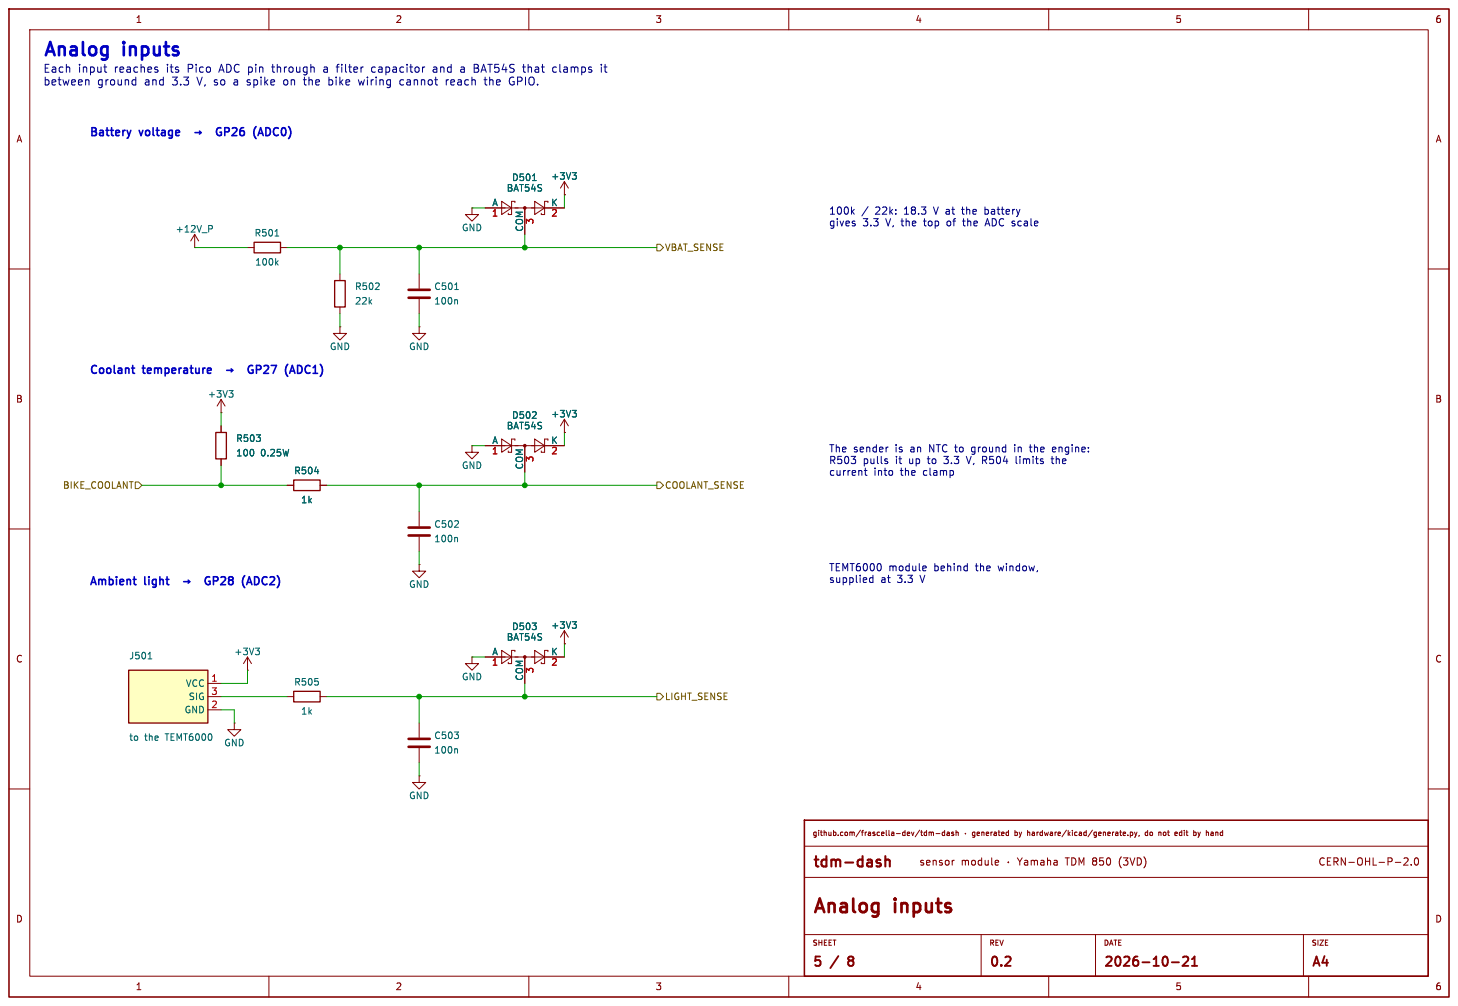
[picture p79: page 6]

gives 3.3 V, the top of the ADC scale The sender is an NTC to ground in the engine: R503 pulls it up to 3.3 V, R504 limits the

current into the clamp TEMT6000 module behind the window,

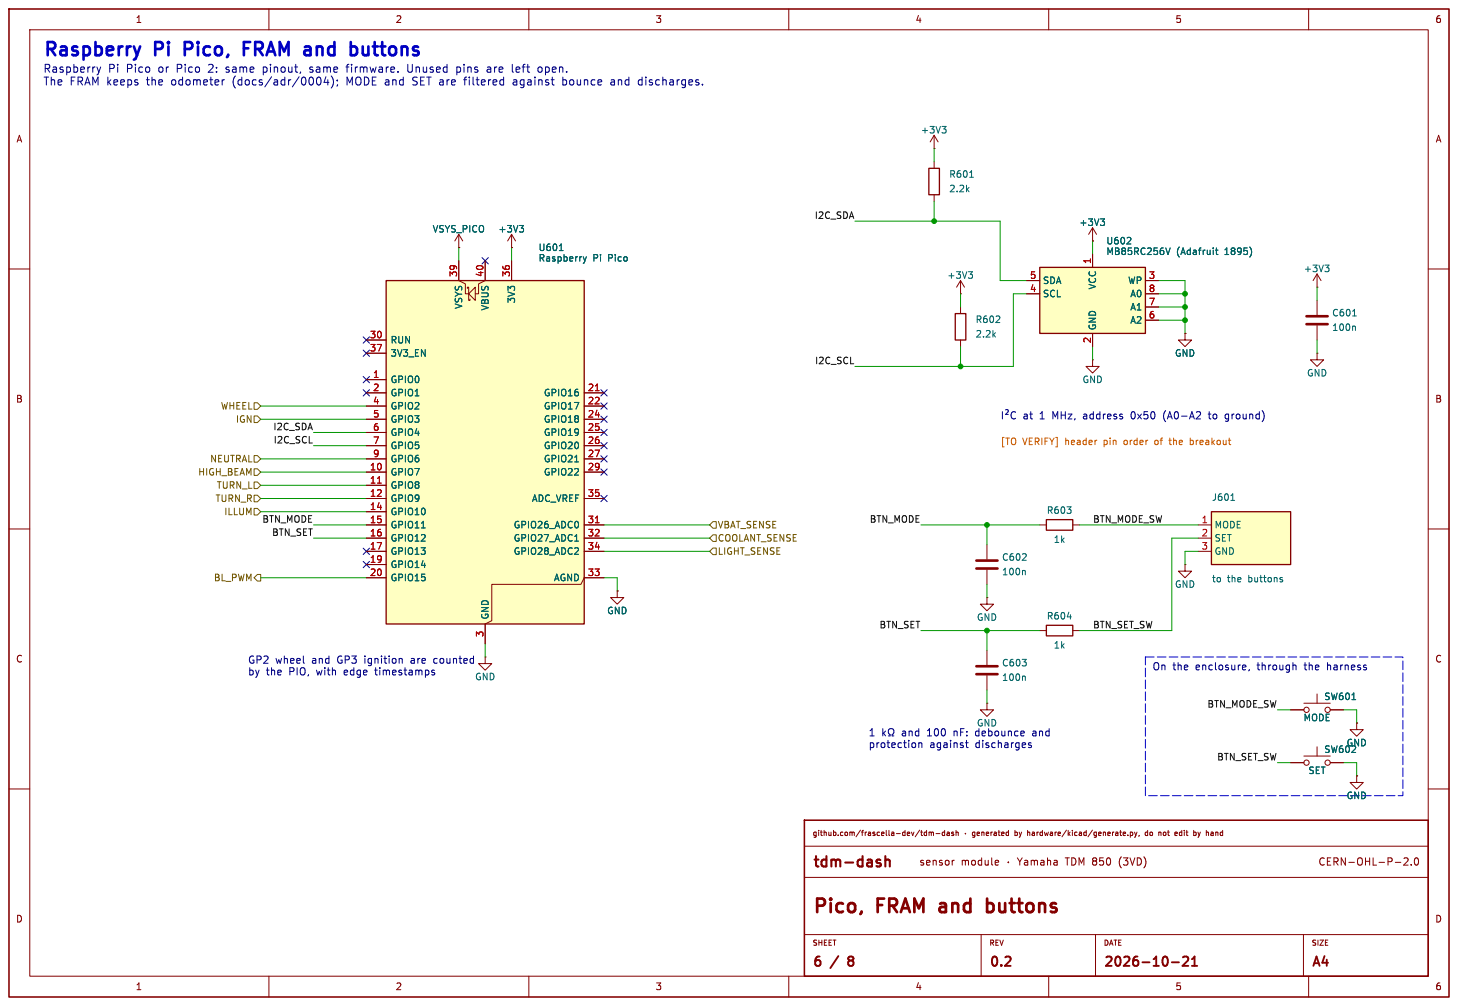
[picture p80: page 7]

2 WP 3 A0 8 A1 7 A2 6 U602 MB85RC256V (Adafruit 1895) +3V3 GND MODE 1 SET 2 GND 3

U601 Raspberry Pi Pico RUN 30

3 3V3 36 GPIO16 21 GPIO17 22 GPIO18 24 GPIO19 25 GPIO20 26 GPIO21 27 GPIO22 29 ADC_VREF 35 GPIO26_ADC0 31 GPIO27_ADC1 32 GPIO28_ADC2 34 AGND 33 U601 Raspberry Pi Pico GND GND

by the PIO, with edge timestamps

1 þÿk©and 100 nF: debounce and

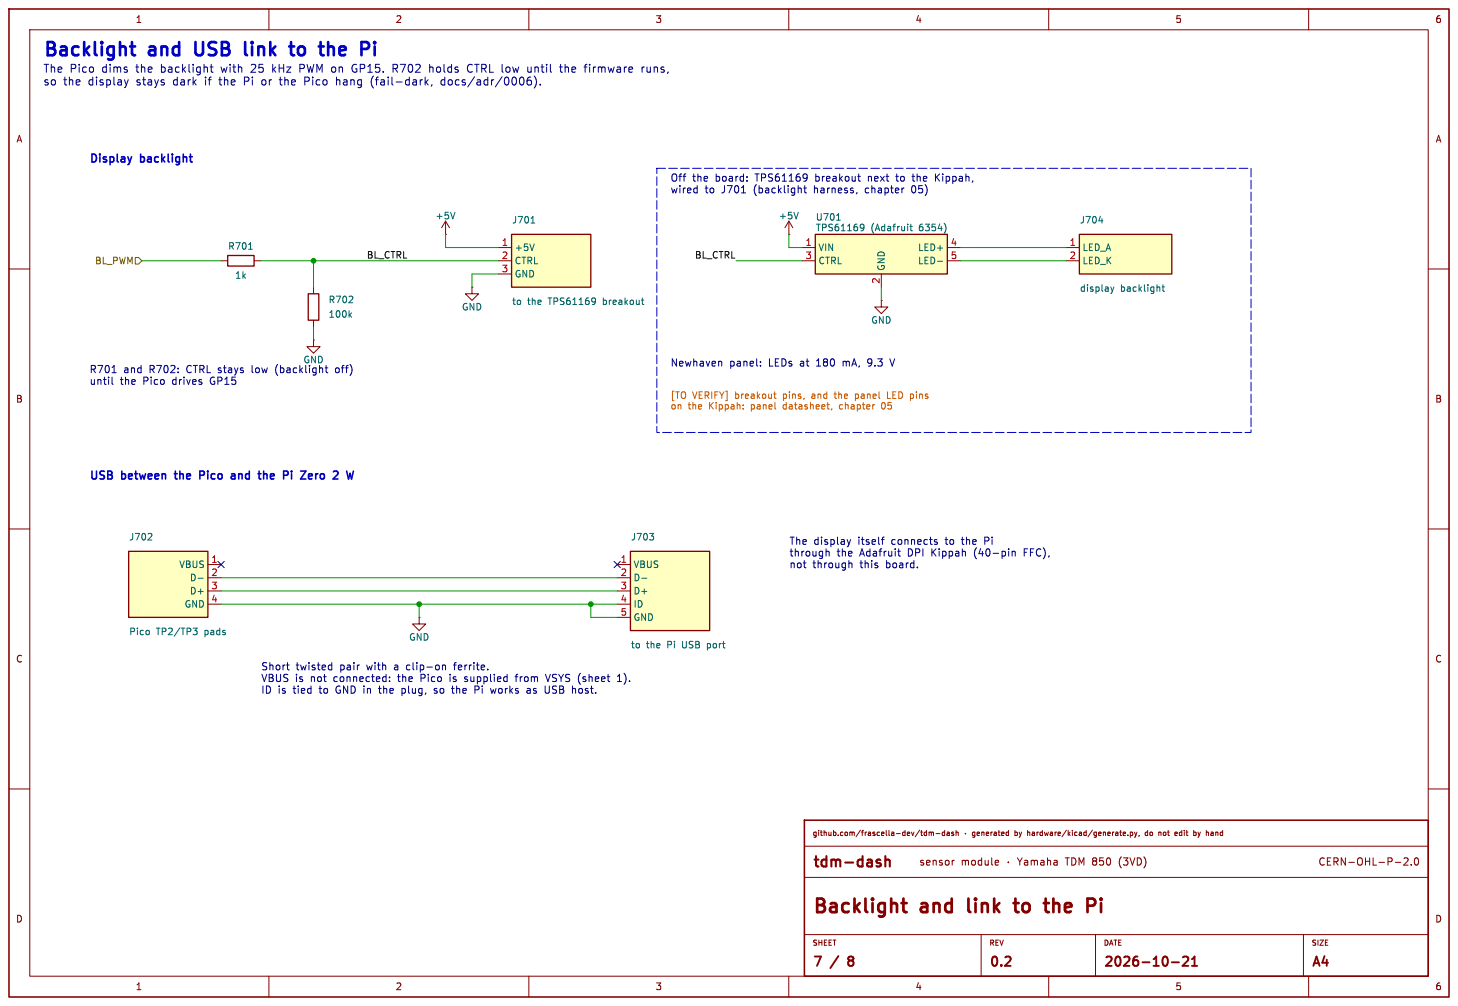
[picture p81: page 8]

to the Pi USB port GND

ID is tied to GND in the plug, so the Pi works as USB host.

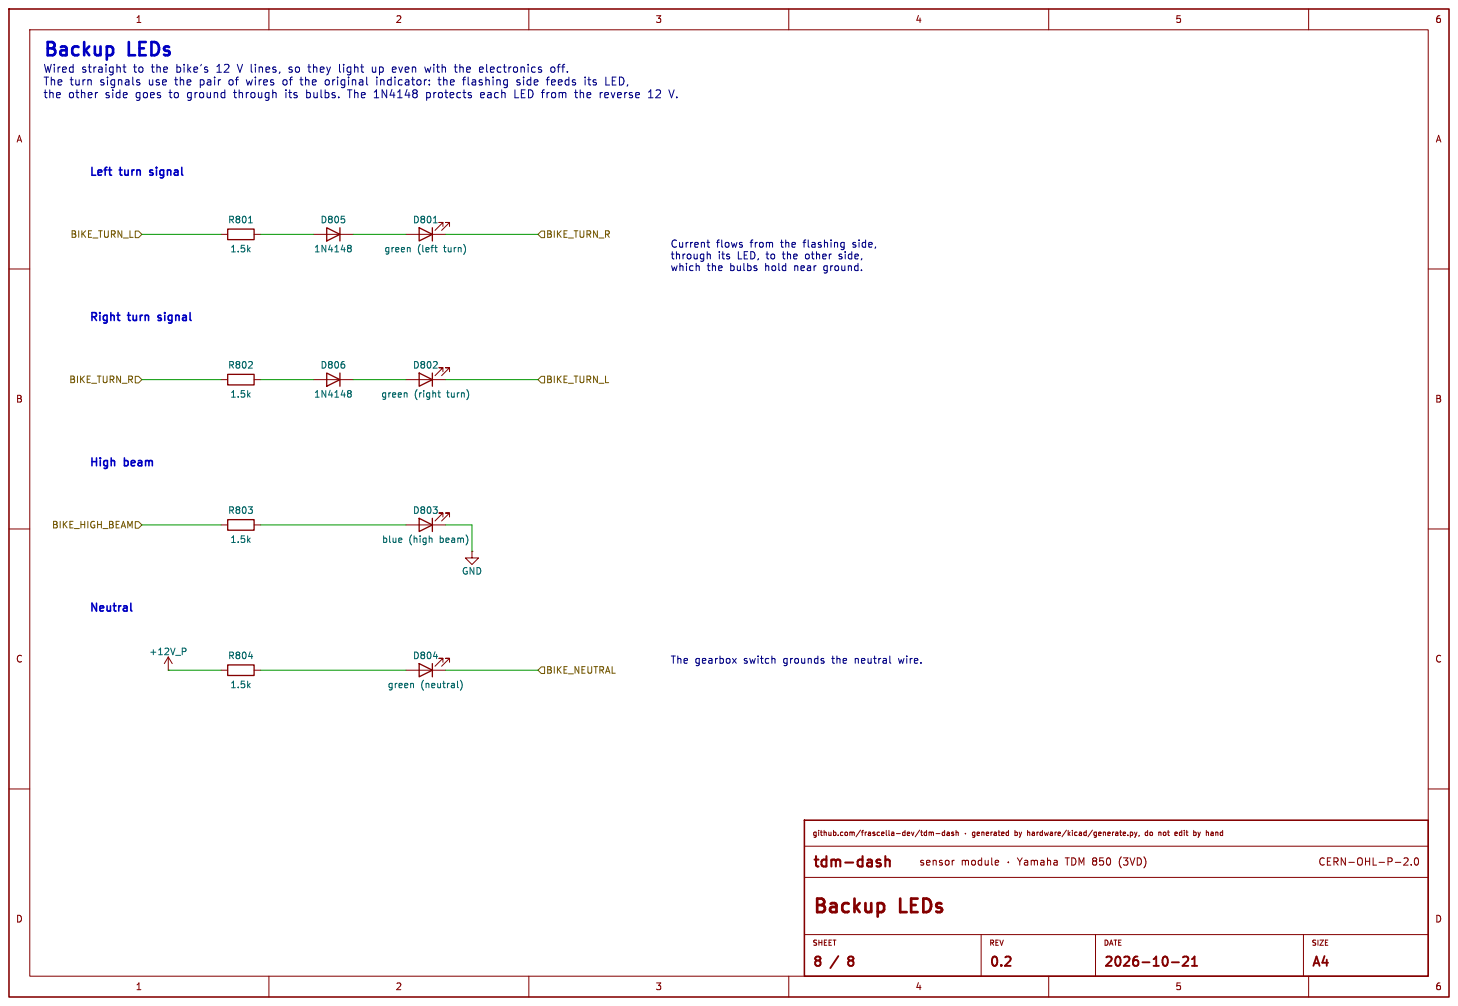
[picture p82: page 9]

through its LED, to the other side, which the bulbs hold near ground. The gearbox switch grounds the neutral wire. Backup LEDs
