frascella-dev/tdm-dash/hardware/kicad/analog.kicad_sch

## KiCad design hardware/kicad/analog.kicad_sch (2026-10-21)

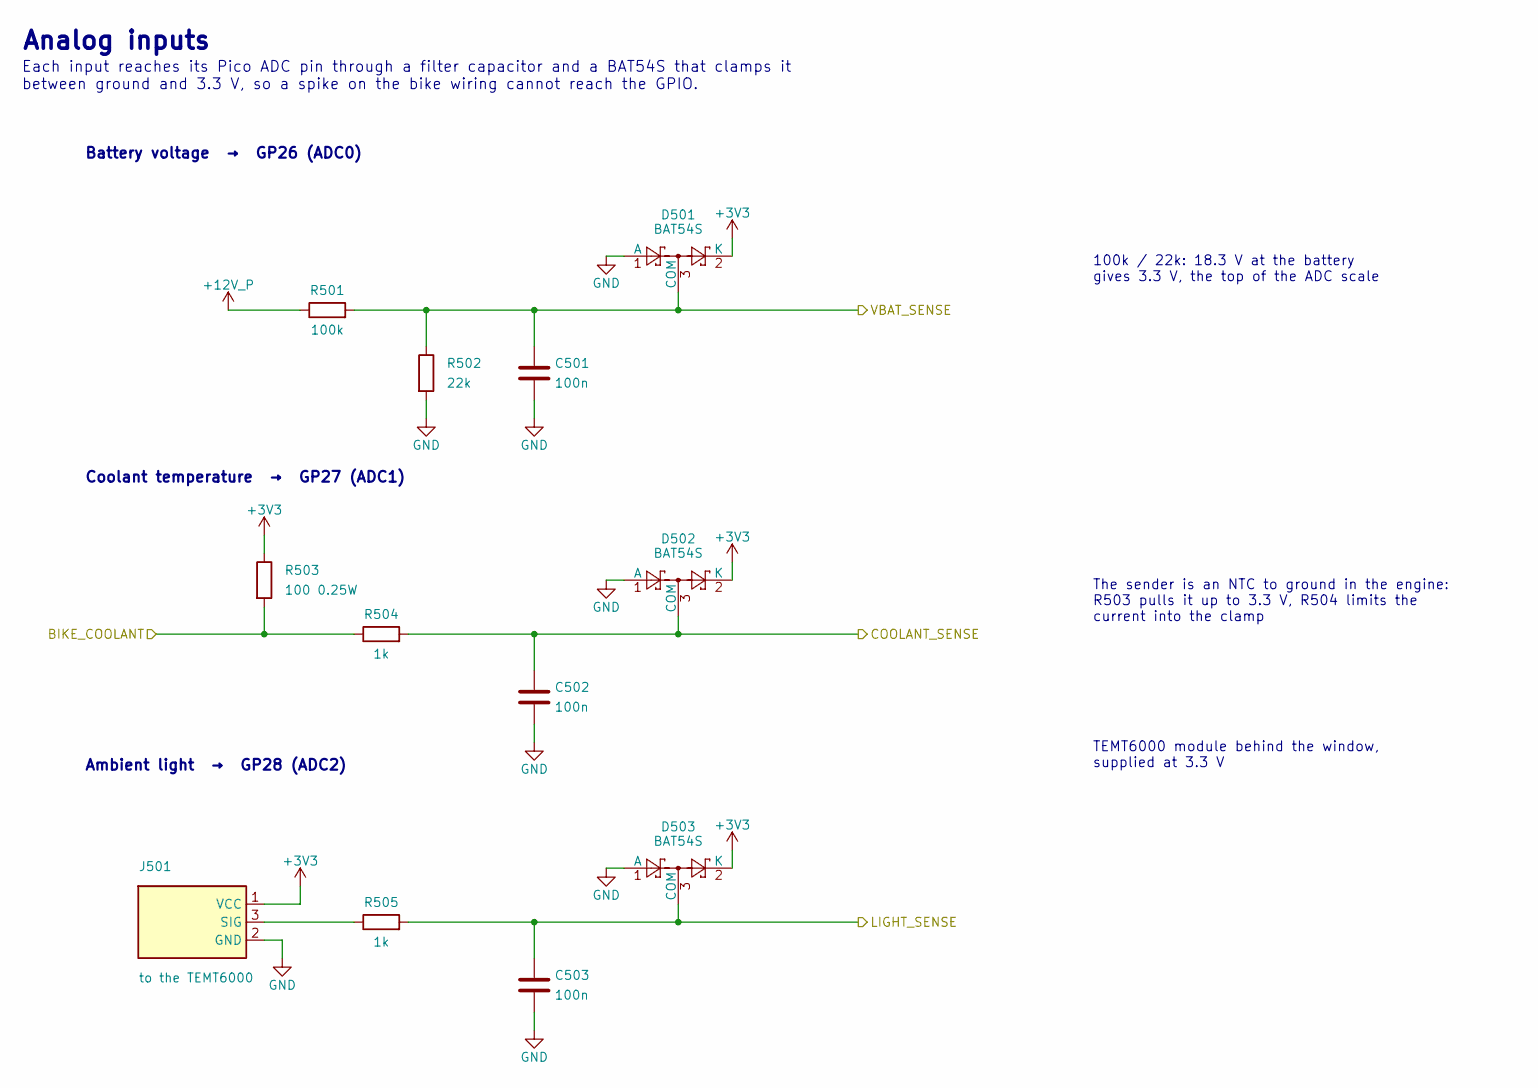
[picture p83: schematic analog.kicad_sch]

Parts:
C501, C502, C503: 100n
D501, D502, D503: BAT54S; SOT-23
J501: to the TEMT6000
R501: 100k
R502: 22k
R503: 100 0.25W
R504, R505: 1k

Connections:
+3V3: D501.2 (K), D502.2 (K), D503.2 (K), J501.1 (VCC), R503.1
+12V_P: R501.1
BIKE_COOLANT: R503.2, R504.1
COOLANT_SENSE: C502.1, D502.3 (COM), R504.2
GND: C501.2, C502.2, C503.2, D501.1 (A), D502.1 (A), D503.1 (A), J501.2 (GND), R502.2
LIGHT_SENSE: C503.1, D503.3 (COM), R505.2
unnamed: J501.3 (SIG), R505.1
VBAT_SENSE: C501.1, D501.3 (COM), R501.2, R502.1

Notes on the sheet:
Analog inputs
Each input reaches its Pico ADC pin through a filter capacitor and a BAT54S that clamps it between ground and 3.3 V, so a spike on the bike wiring cannot reach the GPIO.
Battery voltage → GP26 (ADC0)
100k / 22k: 18.3 V at the battery gives 3.3 V, the top of the ADC scale
Coolant temperature → GP27 (ADC1)
The sender is an NTC to ground in the engine: R503 pulls it up to 3.3 V, R504 limits the current into the clamp
Ambient light → GP28 (ADC2)
TEMT6000 module behind the window, supplied at 3.3 V
