frascella-dev/tdm-dash/hardware/kicad/backlight.kicad_sch

## KiCad design hardware/kicad/backlight.kicad_sch (2026-10-21)

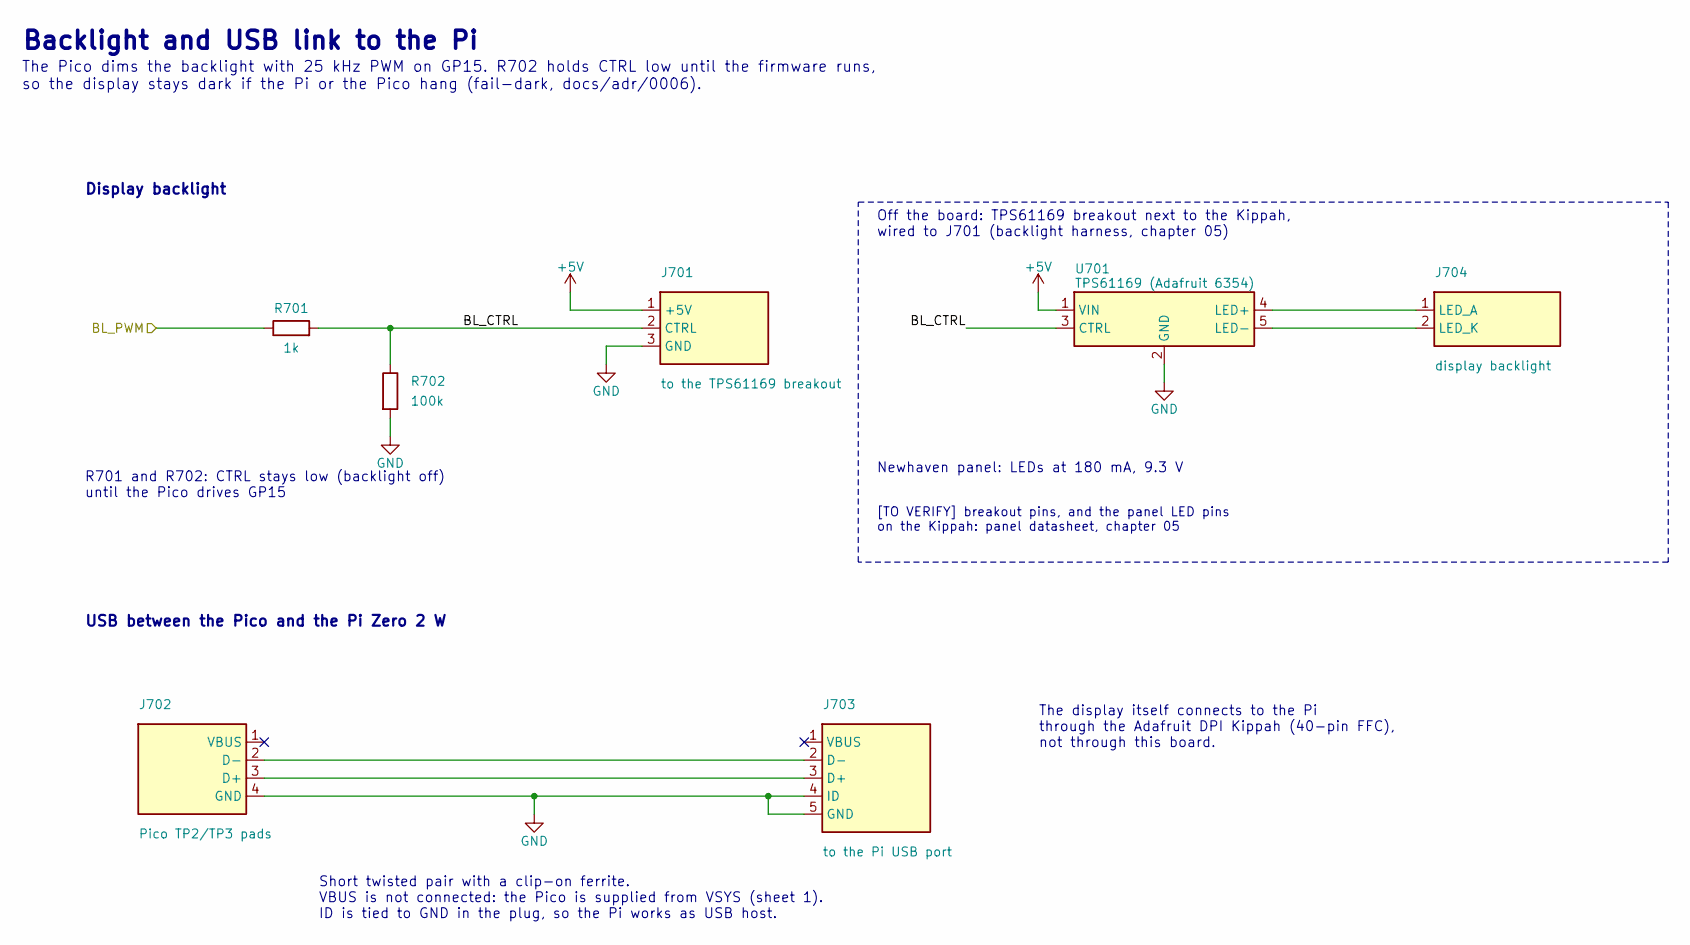
[picture p84: schematic backlight.kicad_sch]

Parts:
J701: to the TPS61169 breakout
J702: Pico TP2/TP3 pads
J703: to the Pi USB port
J704: display backlight
R701: 1k
R702: 100k
U701: TPS61169 (Adafruit 6354)

Connections:
+5V: J701.1 (+5V), U701.1 (VIN)
BL_CTRL: J701.2 (CTRL), R701.2, R702.1, U701.3 (CTRL)
BL_PWM: R701.1
GND: J701.3 (GND), J702.4 (GND), J703.4 (ID), J703.5 (GND), R702.2, U701.2 (GND)
unnamed: J702.2 (D-), J703.2 (D-)
unnamed: J702.3 (D+), J703.3 (D+)
unnamed: J704.1 (LED_A), U701.4 (LED+)
unnamed: J704.2 (LED_K), U701.5 (LED-)

Notes on the sheet:
Backlight and USB link to the Pi
The Pico dims the backlight with 25 kHz PWM on GP15. R702 holds CTRL low until the firmware runs, so the display stays dark if the Pi or the Pico hang (fail-dark, docs/adr/0006).
Display backlight
R701 and R702: CTRL stays low (backlight off) until the Pico drives GP15
Off the board: TPS61169 breakout next to the Kippah, wired to J701 (backlight harness, chapter 05)
Newhaven panel: LEDs at 180 mA, 9.3 V
[TO VERIFY] breakout pins, and the panel LED pins on the Kippah: panel datasheet, chapter 05
USB between the Pico and the Pi Zero 2 W
Short twisted pair with a clip-on ferrite. VBUS is not connected: the Pico is supplied from VSYS (sheet 1). ID is tied to GND in the plug, so the Pi works as USB host.
The display itself connects to the Pi through the Adafruit DPI Kippah (40-pin FFC), not through this board.
