frascella-dev/tdm-dash/hardware/kicad/inputs.kicad_sch

## KiCad design hardware/kicad/inputs.kicad_sch (2026-10-21)

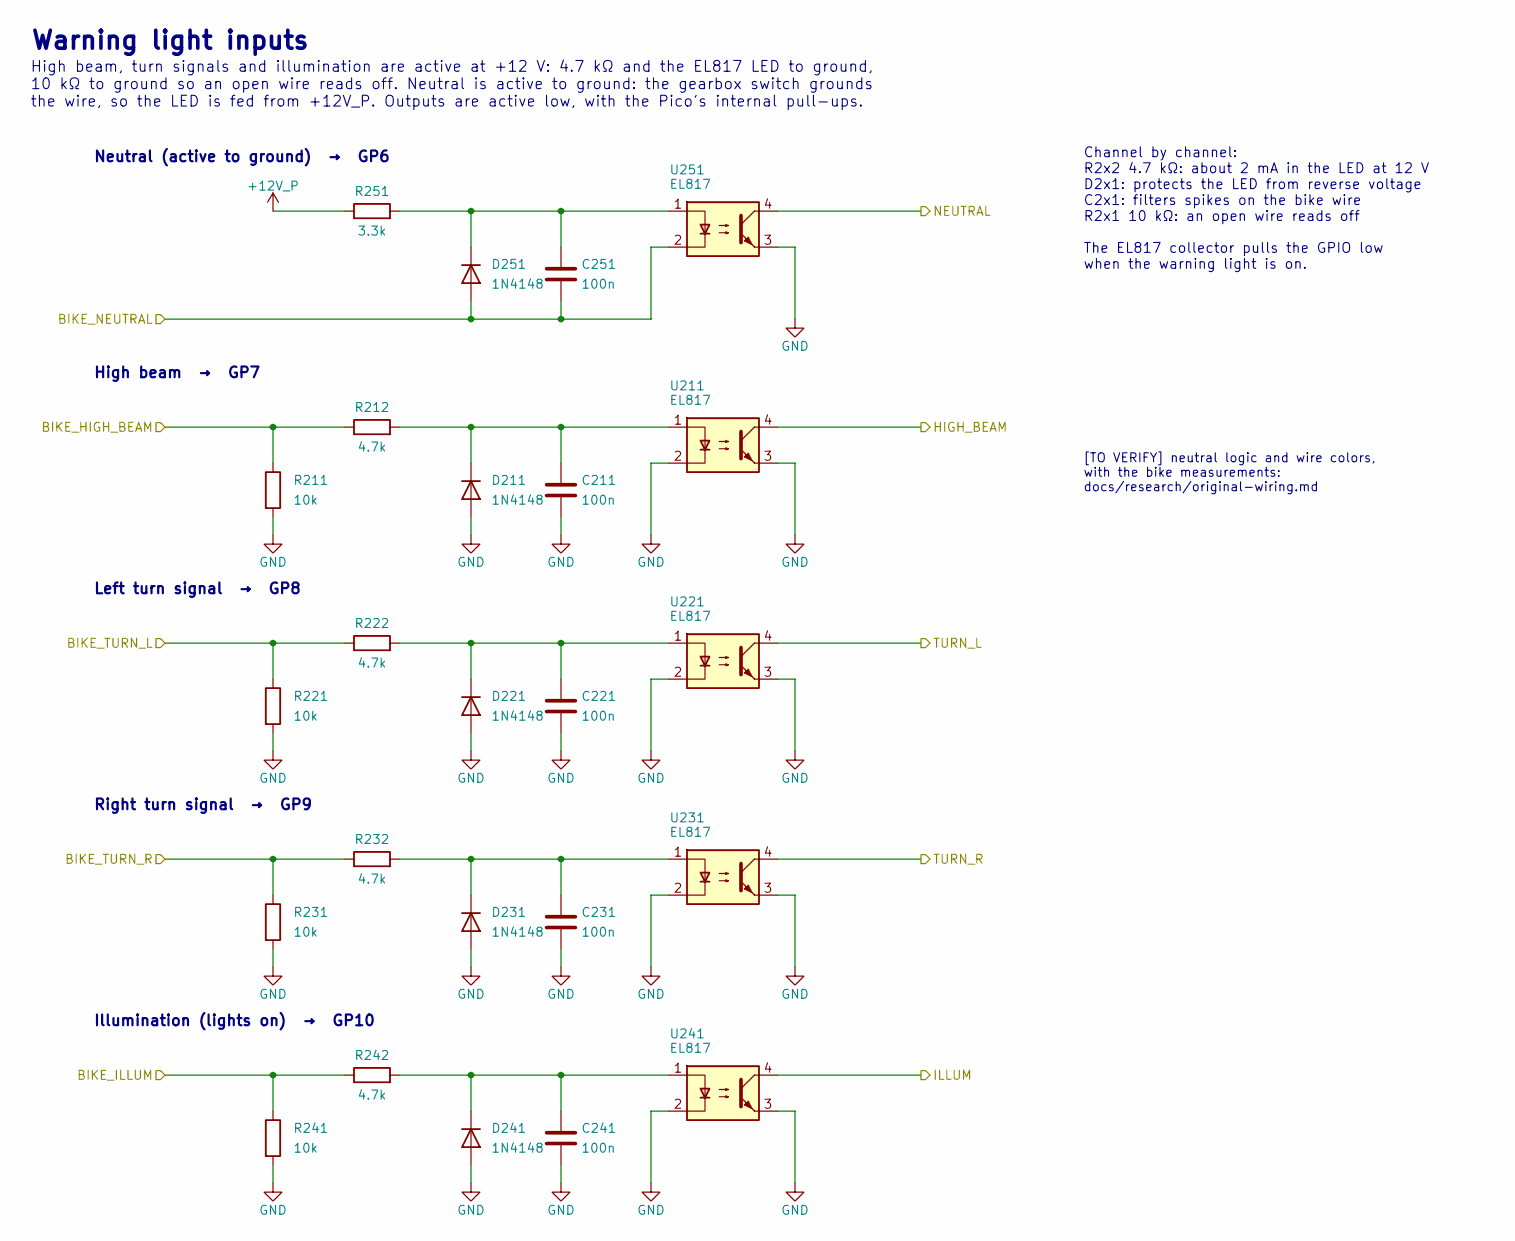
[picture p85: schematic inputs.kicad_sch]

Parts:
C211, C221, C231, C241, C251: 100n
D211, D221, D231, D241, D251: 1N4148; D_DO-35_SOD27_P7.62mm_Horizontal
R211, R221, R231, R241: 10k
R212, R222, R232, R242: 4.7k
R251: 3.3k
U211, U221, U231, U241, U251: EL817; DIP-4_W7.62mm

Connections:
+12V_P: R251.1
BIKE_HIGH_BEAM: R211.1, R212.1
BIKE_ILLUM: R241.1, R242.1
BIKE_NEUTRAL: C251.2, D251.2 (A), U251.2
BIKE_TURN_L: R221.1, R222.1
BIKE_TURN_R: R231.1, R232.1
GND: C211.2, C221.2, C231.2, C241.2, D211.2 (A), D221.2 (A), D231.2 (A), D241.2 (A), R211.2, R221.2, R231.2, R241.2, U211.2, U211.3, U221.2, U221.3, U231.2, U231.3, U241.2, U241.3, U251.3
HIGH_BEAM: U211.4
ILLUM: U241.4
NEUTRAL: U251.4
unnamed: C211.1, D211.1 (K), R212.2, U211.1
unnamed: C221.1, D221.1 (K), R222.2, U221.1
unnamed: C231.1, D231.1 (K), R232.2, U231.1
unnamed: C241.1, D241.1 (K), R242.2, U241.1
unnamed: C251.1, D251.1 (K), R251.2, U251.1
TURN_L: U221.4
TURN_R: U231.4

Notes on the sheet:
Warning light inputs
High beam, turn signals and illumination are active at +12 V: 4.7 kΩ and the EL817 LED to ground, 10 kΩ to ground so an open wire reads off. Neutral is active to ground: the gearbox switch grounds the wire, so the LED is fed from +12V_P. Outputs are active low, with the Pico's internal pull-ups.
Neutral (active to ground) → GP6
High beam → GP7
Left turn signal → GP8
Right turn signal → GP9
Illumination (lights on) → GP10
Channel by channel: R2x2 4.7 kΩ: about 2 mA in the LED at 12 V D2x1: protects the LED from reverse voltage C2x1: filters spikes on the bike wire R2x1 10 kΩ: an open wire reads off The EL817 collector pulls the GPIO low when the warning light is on.
[TO VERIFY] neutral logic and wire colors, with the bike measurements: docs/research/original-wiring.md
