frascella-dev/tdm-dash/hardware/kicad/leds.kicad_sch

## KiCad design hardware/kicad/leds.kicad_sch (2026-10-21)

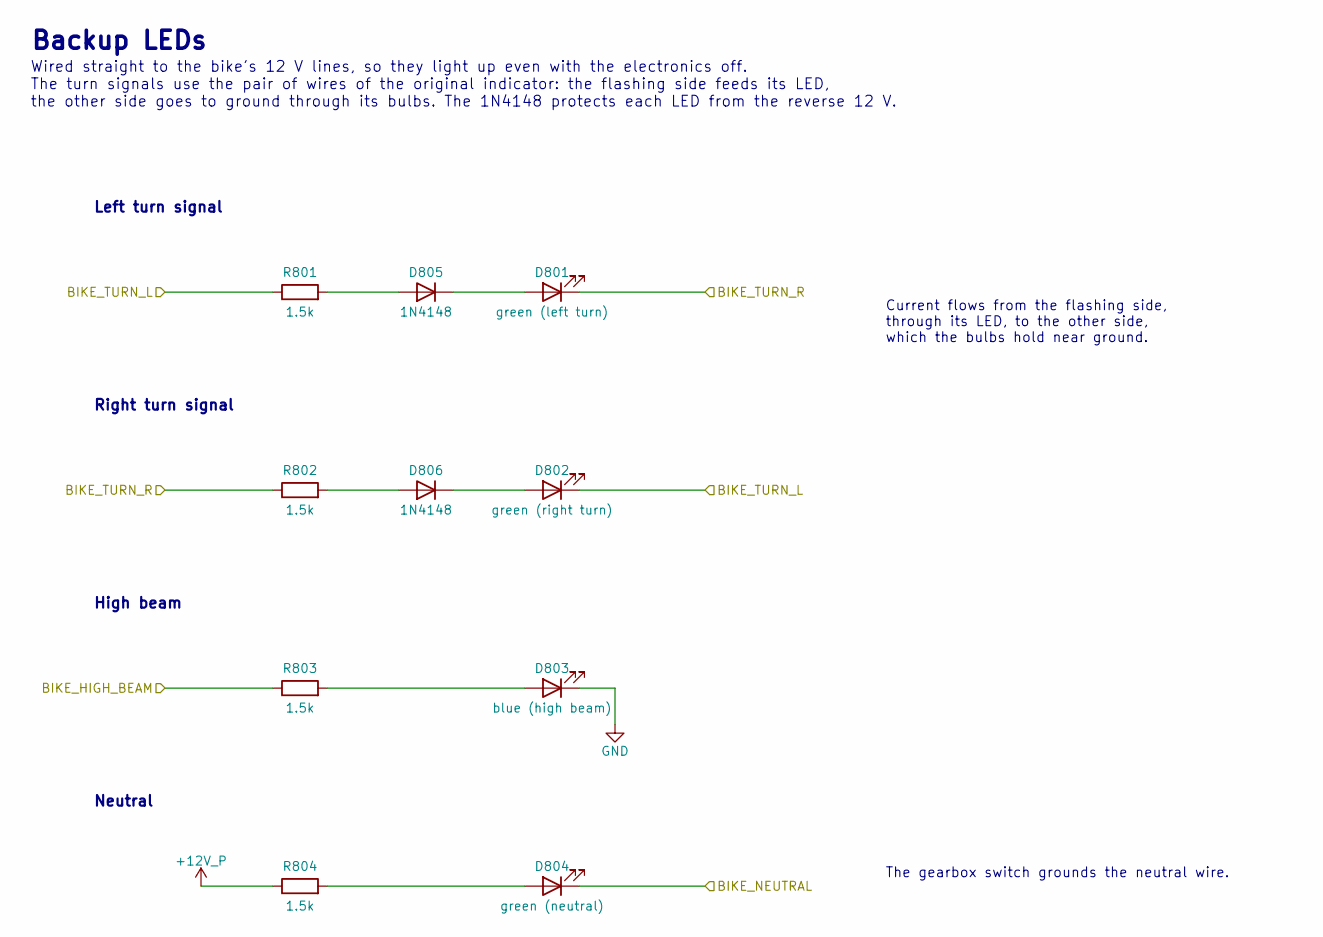
[picture p86: schematic leds.kicad_sch]

Parts:
D801: green (left turn)
D802: green (right turn)
D803: blue (high beam)
D804: green (neutral)
D805, D806: 1N4148; D_DO-35_SOD27_P7.62mm_Horizontal
R801, R802, R803, R804: 1.5k

Connections:
+12V_P: R804.1
BIKE_HIGH_BEAM: R803.1
BIKE_NEUTRAL: D804.1 (K)
BIKE_TURN_L: D802.1 (K), R801.1
BIKE_TURN_R: D801.1 (K), R802.1
GND: D803.1 (K)
unnamed: D801.2 (A), D805.1 (K)
unnamed: D802.2 (A), D806.1 (K)
unnamed: D803.2 (A), R803.2
unnamed: D804.2 (A), R804.2
unnamed: D805.2 (A), R801.2
unnamed: D806.2 (A), R802.2

Notes on the sheet:
Backup LEDs
Wired straight to the bike's 12 V lines, so they light up even with the electronics off. The turn signals use the pair of wires of the original indicator: the flashing side feeds its LED, the other side goes to ground through its bulbs. The 1N4148 protects each LED from the reverse 12 V.
Left turn signal
Right turn signal
Current flows from the flashing side, through its LED, to the other side, which the bulbs hold near ground.
High beam
Neutral
The gearbox switch grounds the neutral wire.
