frascella-dev/tdm-dash/hardware/kicad/mcu.kicad_sch

## KiCad design hardware/kicad/mcu.kicad_sch (2026-10-21)

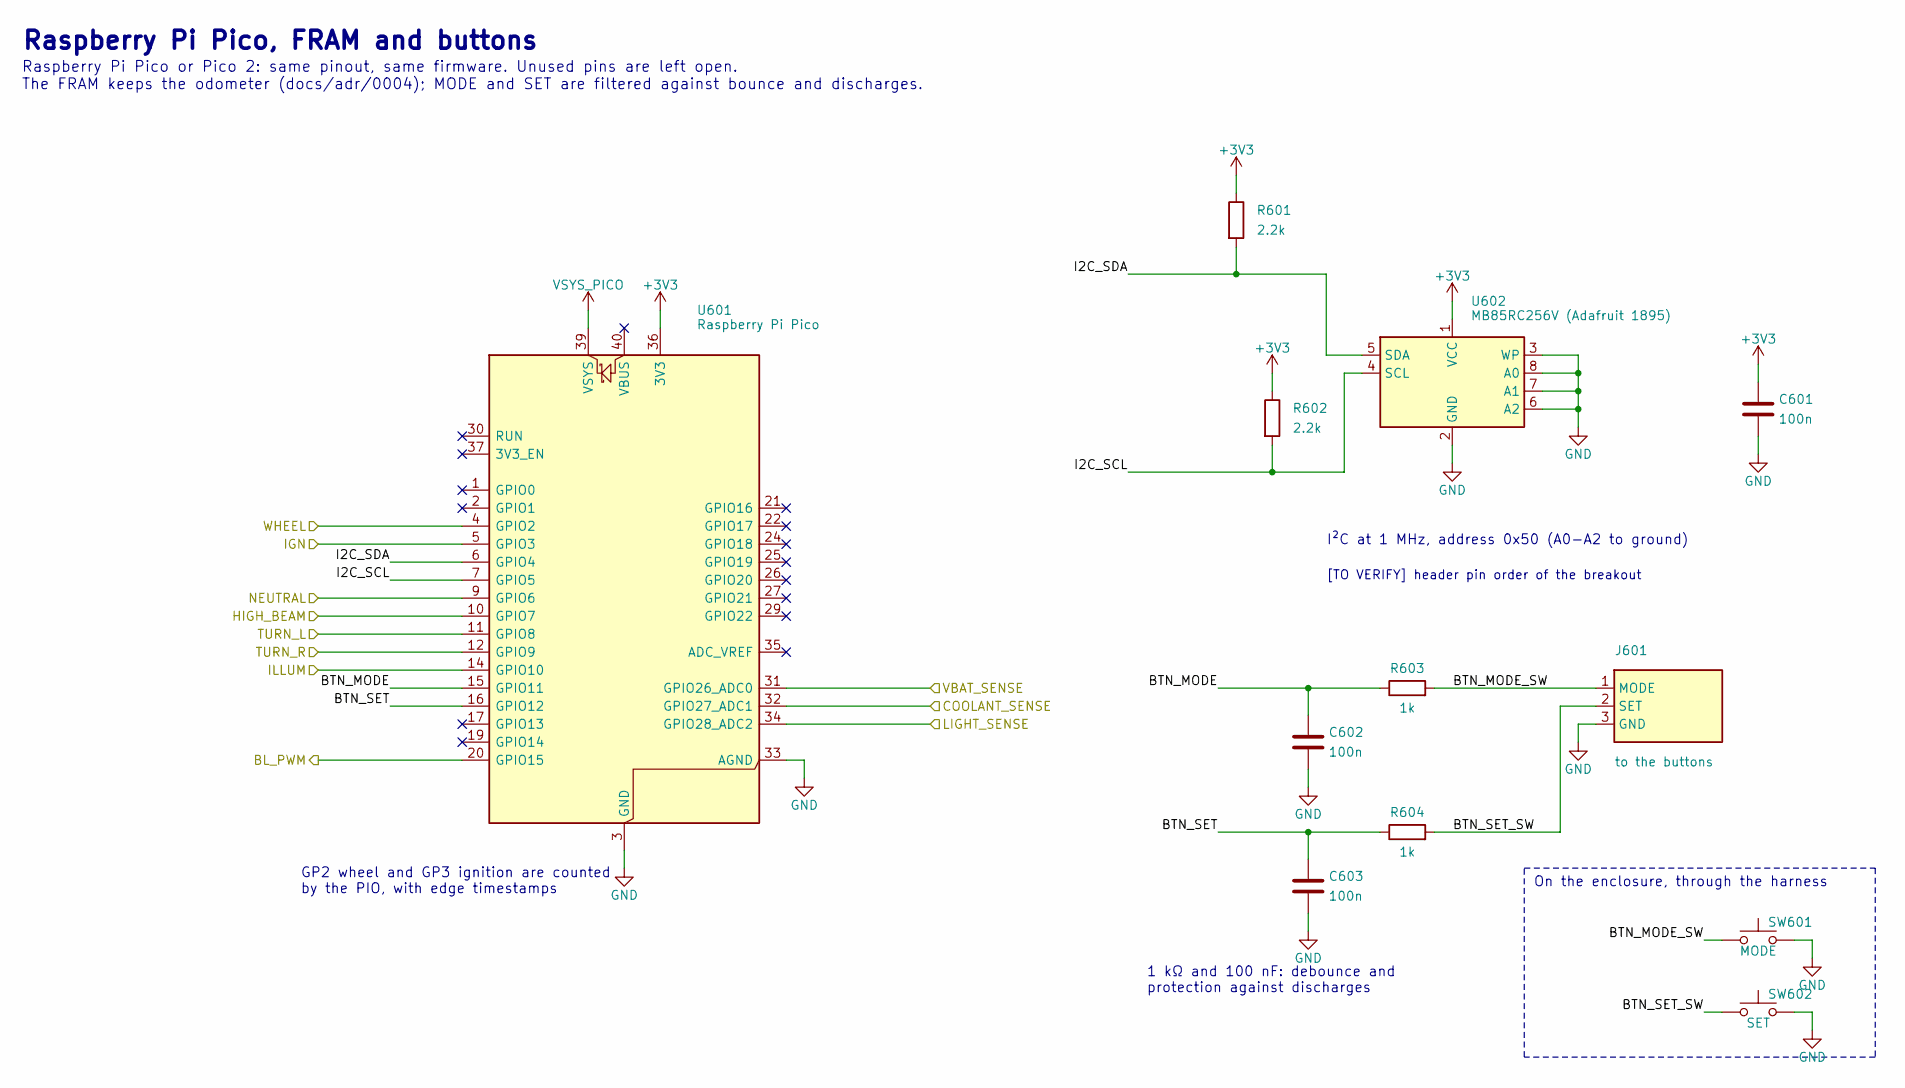
[picture p87: schematic mcu.kicad_sch]

Parts:
C601, C602, C603: 100n
J601: to the buttons
R601, R602: 2.2k
R603, R604: 1k
SW601: MODE
SW602: SET
U601: Raspberry Pi Pico; RaspberryPi_Pico_Common_Unspecified
U602: MB85RC256V (Adafruit 1895)

Connections:
+3V3: C601.1, R601.1, R602.1, U601.36 (3V3), U602.1 (VCC)
BL_PWM: U601.20 (GPIO15)
BTN_MODE: C602.1, R603.1, U601.15 (GPIO11)
BTN_MODE_SW: J601.1 (MODE), R603.2, SW601.1
BTN_SET: C603.1, R604.1, U601.16 (GPIO12)
BTN_SET_SW: J601.2 (SET), R604.2, SW602.1
COOLANT_SENSE: U601.32 (GPIO27_ADC1)
GND: C601.2, C602.2, C603.2, J601.3 (GND), SW601.2, SW602.2, U601.3 (GND), U601.8 (GND), U601.13 (GND), U601.18 (GND), U601.23 (GND), U601.28 (GND), U601.33 (AGND), U601.38 (GND), U602.2 (GND), U602.3 (WP), U602.6 (A2), U602.7 (A1), U602.8 (A0)
HIGH_BEAM: U601.10 (GPIO7)
I2C_SCL: R602.2, U601.7 (GPIO5), U602.4 (SCL)
I2C_SDA: R601.2, U601.6 (GPIO4), U602.5 (SDA)
IGN: U601.5 (GPIO3)
ILLUM: U601.14 (GPIO10)
LIGHT_SENSE: U601.34 (GPIO28_ADC2)
NEUTRAL: U601.9 (GPIO6)
TURN_L: U601.11 (GPIO8)
TURN_R: U601.12 (GPIO9)
VBAT_SENSE: U601.31 (GPIO26_ADC0)
VSYS_PICO: U601.39 (VSYS)
WHEEL: U601.4 (GPIO2)

Notes on the sheet:
Raspberry Pi Pico, FRAM and buttons
Raspberry Pi Pico or Pico 2: same pinout, same firmware. Unused pins are left open. The FRAM keeps the odometer (docs/adr/0004); MODE and SET are filtered against bounce and discharges.
GP2 wheel and GP3 ignition are counted by the PIO, with edge timestamps
I²C at 1 MHz, address 0x50 (A0-A2 to ground)
[TO VERIFY] header pin order of the breakout
On the enclosure, through the harness
1 kΩ and 100 nF: debounce and protection against discharges
