frascella-dev/tdm-dash/hardware/kicad/power.kicad_sch

## KiCad design hardware/kicad/power.kicad_sch (2026-10-21)

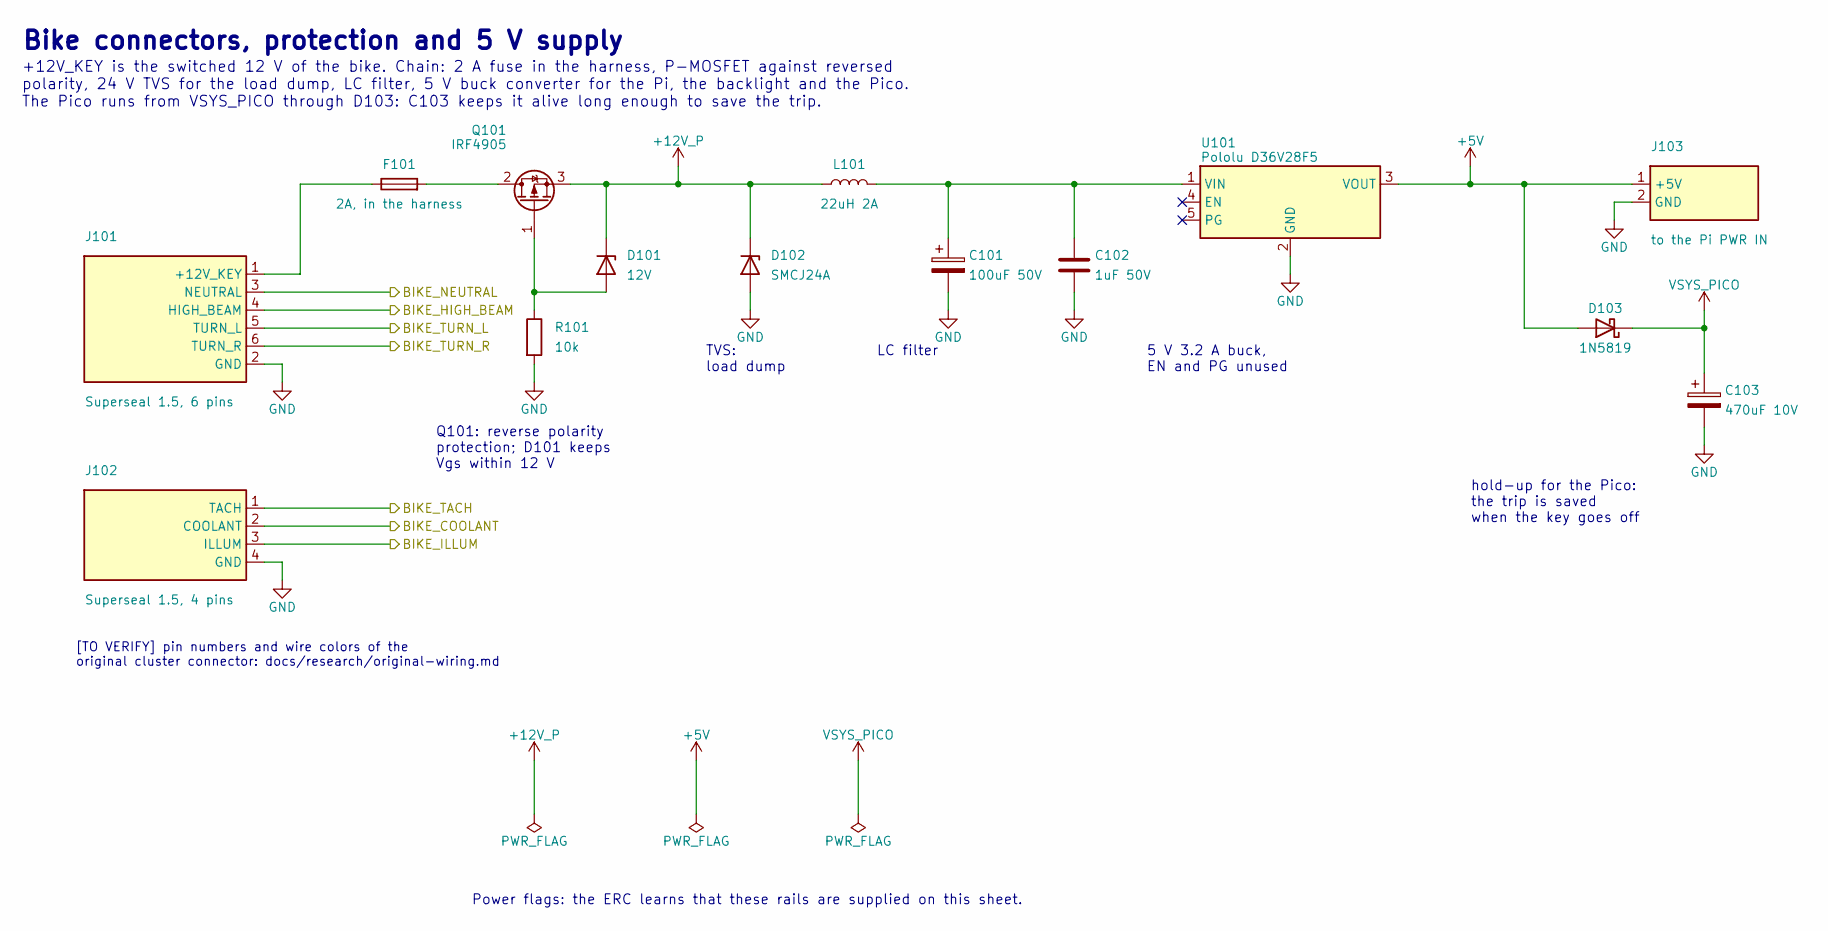
[picture p88: schematic power.kicad_sch]

Parts:
C101: 100uF 50V
C102: 1uF 50V
C103: 470uF 10V
D101: 12V
D102: SMCJ24A
D103: 1N5819; D_DO-41_SOD81_P10.16mm_Horizontal
F101: 2A, in the harness
J101: Superseal 1.5, 6 pins
J102: Superseal 1.5, 4 pins
J103: to the Pi PWR IN
L101: 22uH 2A
Q101: IRF4905; TO-220-3_Vertical
R101: 10k
U101: Pololu D36V28F5

Connections:
+5V: D103.2 (A), J103.1 (+5V), U101.3 (VOUT)
+12V_P: D101.1 (K), D102.1 (K), L101.1, Q101.3 (S)
BIKE_COOLANT: J102.2 (COOLANT)
BIKE_HIGH_BEAM: J101.4 (HIGH_BEAM)
BIKE_ILLUM: J102.3 (ILLUM)
BIKE_NEUTRAL: J101.3 (NEUTRAL)
BIKE_TACH: J102.1 (TACH)
BIKE_TURN_L: J101.5 (TURN_L)
BIKE_TURN_R: J101.6 (TURN_R)
GND: C101.2, C102.2, C103.2, D102.2 (A), J101.2 (GND), J102.4 (GND), J103.2 (GND), R101.2, U101.2 (GND)
unnamed: C101.1, C102.1, L101.2, U101.1 (VIN)
unnamed: D101.2 (A), Q101.1 (G), R101.1
unnamed: F101.1, J101.1 (+12V_KEY)
unnamed: F101.2, Q101.2 (D)
VSYS_PICO: C103.1, D103.1 (K)

Notes on the sheet:
Bike connectors, protection and 5 V supply
+12V_KEY is the switched 12 V of the bike. Chain: 2 A fuse in the harness, P-MOSFET against reversed polarity, 24 V TVS for the load dump, LC filter, 5 V buck converter for the Pi, the backlight and the Pico. The Pico runs from VSYS_PICO through D103: C103 keeps it alive long enough to save the tri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
[TO VERIFY] pin numbers and wire colors of the original cluster connector: docs/research/original-wiring.md
Q101: reverse polarity protection; D101 keeps Vgs within 12 V
TVS: load dump
LC filter
5 V 3.2 A buck, EN and PG unused
hold-up for the Pico: the trip is saved when the key goes off
Power flags: the ERC learns that these rails are supplied on this sheet.
