frascella-dev/tdm-dash/hardware/kicad/tach.kicad_sch

## KiCad design hardware/kicad/tach.kicad_sch (2026-10-21)

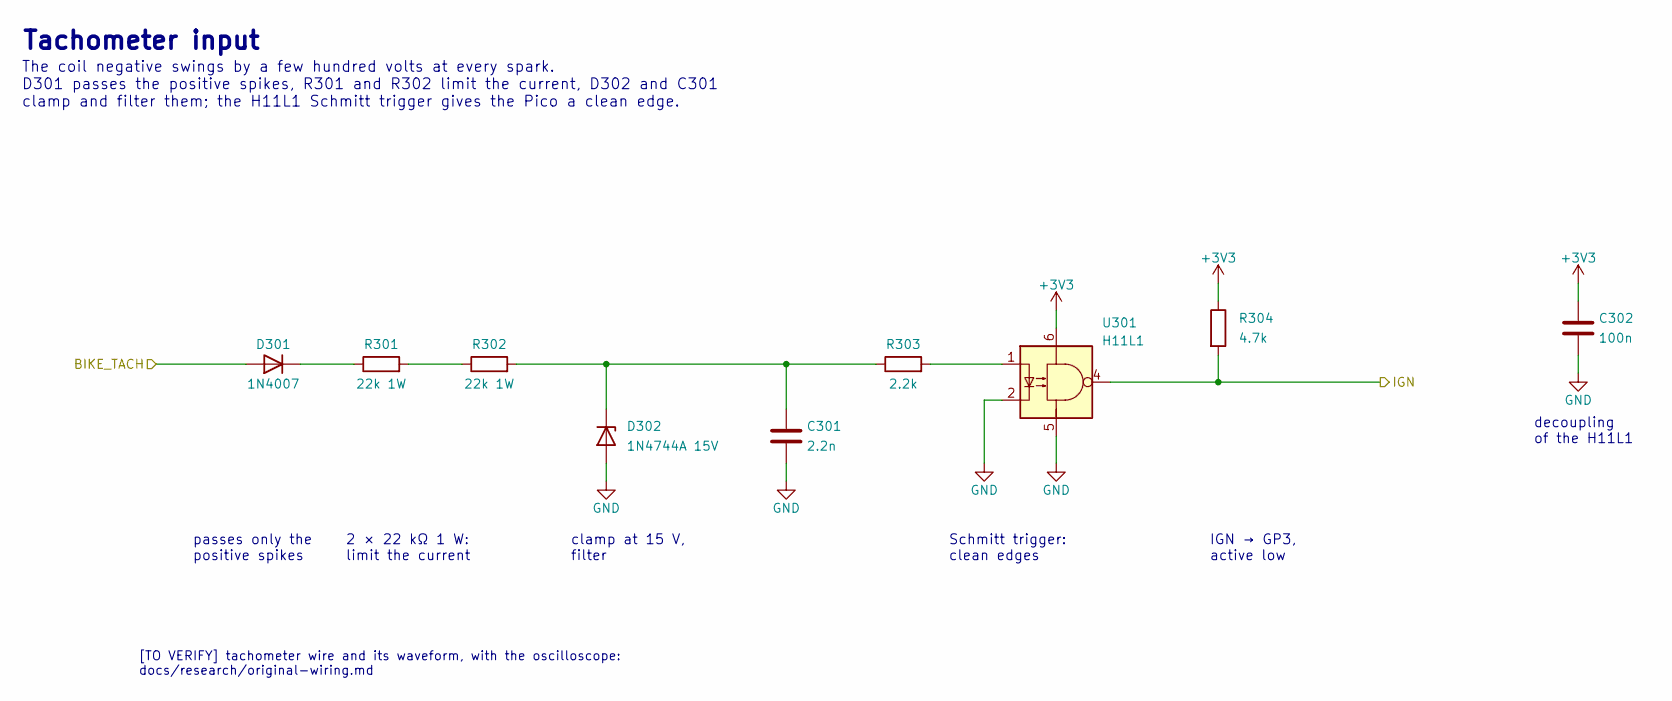
[picture p89: schematic tach.kicad_sch]

Parts:
C301: 2.2n
C302: 100n
D301: 1N4007; D_DO-41_SOD81_P10.16mm_Horizontal
D302: 1N4744A 15V
R301, R302: 22k 1W
R303: 2.2k
R304: 4.7k
U301: H11L1

Connections:
+3V3: C302.1, R304.1, U301.6
BIKE_TACH: D301.2 (A)
GND: C301.2, C302.2, D302.2 (A), U301.2, U301.5
IGN: R304.2, U301.4
unnamed: C301.1, D302.1 (K), R302.2, R303.1
unnamed: D301.1 (K), R301.1
unnamed: R301.2, R302.1
unnamed: R303.2, U301.1

Notes on the sheet:
Tachometer input
The coil negative swings by a few hundred volts at every spark. D301 passes the positive spikes, R301 and R302 limit the current, D302 and C301 clamp and filter them; the H11L1 Schmitt trigger gives the Pico a clean edge.
decoupling of the H11L1
passes only the positive spikes
2 × 22 kΩ 1 W: limit the current
clamp at 15 V, filter
Schmitt trigger: clean edges
IGN → GP3, active low
[TO VERIFY] tachometer wire and its waveform, with the oscilloscope: docs/research/original-wiring.md
