frascella-dev/tdm-dash/hardware/kicad/wheel.kicad_sch

## KiCad design hardware/kicad/wheel.kicad_sch (2026-10-21)

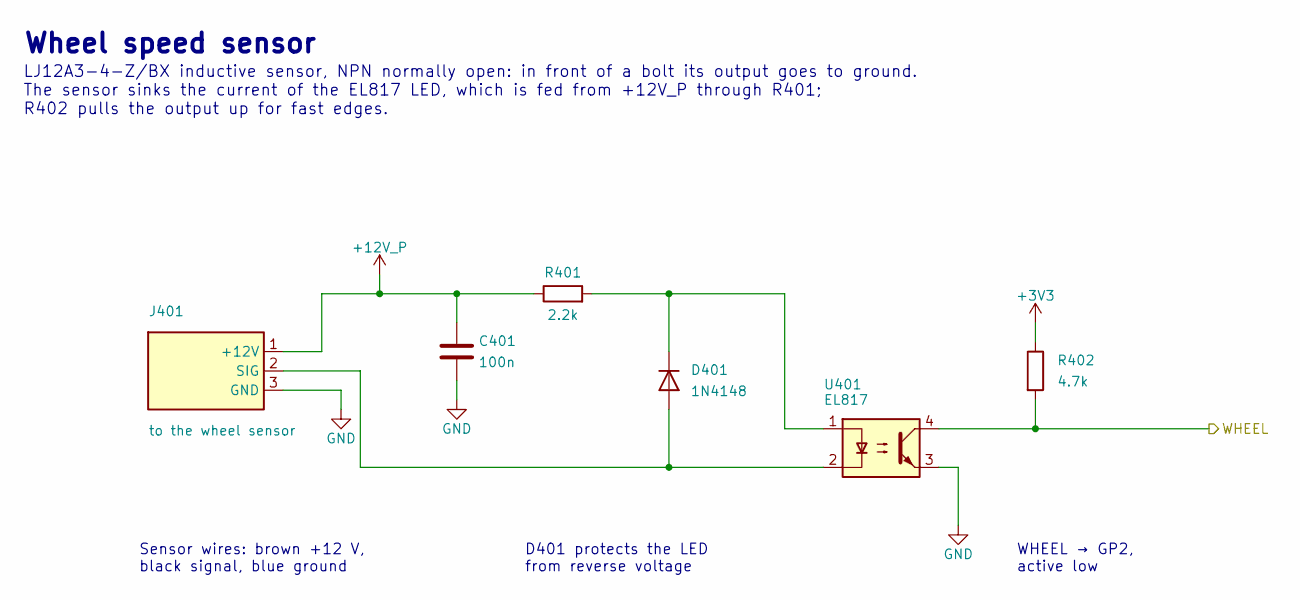
[picture p90: schematic wheel.kicad_sch]

Parts:
C401: 100n
D401: 1N4148; D_DO-35_SOD27_P7.62mm_Horizontal
J401: to the wheel sensor
R401: 2.2k
R402: 4.7k
U401: EL817; DIP-4_W7.62mm

Connections:
+3V3: R402.1
+12V_P: C401.1, J401.1 (+12V), R401.1
GND: C401.2, J401.3 (GND), U401.3
unnamed: D401.1 (K), R401.2, U401.1
unnamed: D401.2 (A), J401.2 (SIG), U401.2
WHEEL: R402.2, U401.4

Notes on the sheet:
Wheel speed sensor
LJ12A3-4-Z/BX inductive sensor, NPN normally open: in front of a bolt its output goes to ground. The sensor sinks the current of the EL817 LED, which is fed from +12V_P through R401; R402 pulls the output up for fast edges.
Sensor wires: brown +12 V, black signal, blue ground
D401 protects the LED from reverse voltage
WHEEL → GP2, active low
