frascella-dev/tdm-dash/crates/tdm-logic/src/lib.rs

//! Dashboard logic: bike profile, conversions, filters, warnings and the UI
//! state machine. No I/O: link events and time go in, a view model and the
//! co-processor commands come out.

pub mod calib;
pub mod conv;
pub mod dash;
pub mod filters;
pub mod fmt;
pub mod i18n;
pub mod profile;
pub mod warnings;

pub use dash::{Dash, Level, LinkEvent, LinkState, Screen, Theme, UiState, ViewModel};
pub use i18n::{Language, Msg, tr};
pub use profile::{Form, Layout, Profile, ThemeMode};
pub use warnings::{Icon, Severity, WarningId};
