frascella-dev/tdm-dash/firmware/build.rs

//! Puts the memory layout of the selected chip where the linker finds it.

use std::env;
use std::fs;
use std::path::PathBuf;

fn main() {
    let out = PathBuf::from(env::var_os("OUT_DIR").unwrap());
    let memory = if env::var_os("CARGO_FEATURE_RP2350").is_some() {
        "memory-rp2350.x"
    } else {
        "memory-rp2040.x"
    };
    fs::copy(memory, out.join("memory.x")).unwrap();
    println!("cargo:rustc-link-search={}", out.display());
    println!("cargo:rerun-if-changed=memory-rp2040.x");
    println!("cargo:rerun-if-changed=memory-rp2350.x");
}
