frascella-dev/tdm-dash/(commit log)

2026-10-20 M1: interactive UI design proposal at 800x480
    - design/index.html: canvas simulator of the cluster with Classic, Sport
    and Touring layouts, trip/diagnostics/settings screens, splash and
    self-test, day/night themes with ambient-light automation, warnings,
    link loss and app-hang (fail-dark) behaviour; filters and pulse
    measurement mirror the planned Rust implementation
    - design/README.md: simulated pipeline, layouts, colour tokens and
    Slint implementation rules
    - pages.yml: publish the design page to GitHub Pages
    Claude-Session: https://claude.ai/code/session_01G9D4Wshjz9MkaThp4wsrGP
2026-10-20 Switch to a 7-inch 800x480 1000-nit display; fix docs link check
    - ADR 0009: Newhaven NHD-7.0-800480AF-ASXP over DPI replaces the
    4.3-inch Crystalfontz panel; datasheet pinout, backlight (180 mA at
    9.3 V) and timing recorded; bar displays rejected (<= 600 nit)
    - BOM, README and architecture diagram updated; total now ~190-240 EUR
    - CI: install mermaid-cli outside the checkout and exclude node_modules
    from lychee, which was failing on Markdown shipped in npm packages
    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
2026-10-21 M2: Rust workspace, desktop simulator and Slint UI
    - tdm-proto: message set, COBS framing with direction-tagged CRC-16,
    resynchronising decoder (echo, garbage and bit-flip tests)
    - tdm-core: PulseMeter over whole wheel revolutions with ignition
    blanking, debouncer, power-fail-safe FRAM records and McuCore, the
    co-processor logic shared by firmware and simulator
    - tdm-logic: TOML bike profile, conversions, filters, warnings and the
    Dash state machine producing a view model and MCU commands; displayed
    speed is checked never to be below true speed (UNECE R39)
    - tdm-link: vehicle simulator with eight scenarios, serial source with
    VID:PID discovery and reconnection, record/replay, tdm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
    [app.rs, build.rs, conv.rs, dash.rs, debounce.rs, filters.rs, fmt.rs, geometry.rs]
2026-10-21 M3: RP2040/RP2350 firmware
    - firmware/: embassy-rp application wiring McuCore (shared with the
    simulator) to the hardware: edge timestamps on a high-priority
    interrupt executor, 1 kHz control loop with debounced inputs, ADC
    averaging, power-fail odometer save, FRAM over I2C, 25 kHz backlight
    PWM with fail-dark, watchdog, USB CDC with host-speaks-first
    - Builds for RP2040 (Pico) and RP2350 (Pico 2), clippy clean
    - tools/elf2uf2.py: dependency-free ELF to UF2 converter
    - CI: firmware job producing UF2 artifacts for both chips
    - Manual chapter 09: firmware flashing and verification, bike profile
    Claude-Session: https://claude.ai/c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
    [build.rs, elf2uf2.py, main.rs]
2026-10-21 M3b: KiCad schematic and WireViz harnesses
    - hardware/kicad/generate.py writes the 8-sheet KiCad 9 schematic from a
    per-pin net description (labels on every pin, symbols embedded from the
    KiCad 9 libraries, deterministic UUIDs); ERC is clean
    - hardware/kicad/export.sh runs ERC, the firmware pin cross-check and the
    PDF/SVG export; SVGs are committed in hardware/exports/kicad
    - tools/check_pinmap.py compares the Pico GPIO nets with firmware/src/main.rs
    and the battery divider / coolant pull-up with the software constants
    - five WireViz harnesses (bike adapter, wheel sensor, Pi power and USB,
    backlight, panel) with rendered SVGs and BOMs
    - Hardware workflow: regenerate + diff, ERC, ex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
    [adattatore-quadro.bom.tsv, analog.kicad_sch, backlight.kicad_sch, inputs.kicad_sch, leds.kicad_sch, mcu.kicad_sch, pannello.bom.tsv, pi.bom.tsv]
2026-10-21 M4: Buildroot image for the Pi Zero 2 W
    - os/buildroot: Buildroot 2026.08 as a submodule
    - os/br2-external (TDMDASH): release and development defconfigs based on
    raspberrypizero2w_64_defconfig; the release image boots the cut-down
    firmware, a kernel with the needed drivers built in and no network,
    media, logo or framebuffer console, and a read-only EROFS root with a
    BusyBox inittab that only mounts and respawns the dashboard
    - tdm-dash package: local site method on this checkout, cargo vendor in a
    pre-configure hook, workspace release profile restored, installs
    tdm-dash (KMS), tdmctl and the bike profile (also on the boot partition)
    - config.txt with the Newhaven DPI timings via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
    [config-dev.txt, config.txt]
2026-10-21 Add a README banner
    - tools/stl_outline.py turns a 2.5D line-art STL relief into a flat SVG:
    outline of the base faces, loops inside --drop boxes removed (lettering
    and logos), Ramer-Douglas-Peucker simplification
    - docs/assets/tdm-850.svg: the bike profile from the owner's STL model,
    without trademarks
    - tools/make_banner.py composes docs/assets/banner.svg with the text as
    outlines in the dashboard font and day-theme colours; shown on top of
    the README
    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
2026-10-21 M5: enclosure, sensor bracket, perfboard plan, build manual
    - hardware/enclosure/enclosure.scad: parametric enclosure for the
    Newhaven 7" panel (bezel with window pocket and chamfered aperture,
    rear shell with Pi and perfboard standoffs, gland, breather, buttons,
    light pipe, M5 inserts for the bike, separate sun visor)
    - hardware/bracket/sensor-bracket.scad: flat bracket for the LJ12A3 with
    a radial slot, exported as DXF/SVG for aluminium and STL for fit checks
    - hardware/cad-export.sh and the OpenSCAD CI job; STL, DXF and previews
    in hardware/exports/cad
    - hardware/perfboard/layout.py: zone plan of the 90 x 70 mm perfboard
    - manual chapters 06 (build with a test after every sectio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
    [enclosure-front.stl, enclosure-rear.stl, enclosure-visor.stl, enclosure.scad, sensor-bracket.dxf, sensor-bracket.scad, sensor-bracket.stl]
2026-10-21 M6: calibration tools and the rest of the manual
    - tdm-logic calib module: wheel circumference from a GPS distance, tach
    pulses per revolution from a reference reading (snapped to 0.5),
    battery divider from a multimeter reading, coolant curve from bath
    measurements; corrections beyond +/-10 % are refused; tests check the
    results are accepted by the profile validation
    - tdmctl calibrate wheel|tach|battery|coolant prints the corrected value
    as TOML for /boot/tdm-dash.toml
    - manual chapters 10 (calibration), 12 (diagnostics with symptom-to-check
    flowcharts and expected measurements) and 13 (maintenance); README with
    milestone status and next steps on the bike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
    [calib.rs, lib.rs]
2026-10-21 Translate code, hardware and docs to English; bilingual dashboard
    - tdm-logic i18n module: every dashboard text in English and Italian,
    chosen by `[display] language` in the profile (English by default, the
    TDM 850 profile keeps Italian); number formatting per language
    - Slint fixed labels moved to a `Labels` global filled from the same table;
    `tdm-dash --language en|it`; reference screens regenerated in English with
    Italian check screens
    - tdmctl, tdm-dash CLI, simulator scenarios, calibration errors and tools
    print English
    - KiCad sheets, WireViz harnesses, perfboard plan and CAD comments in
    English, exports regenerated with the new names
    - manual, research, ADRs and READMEs tr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
    [adattatore-quadro.bom.tsv, analog.kicad_sch, backlight.bom.tsv, backlight.kicad_sch, bike-adapter.bom.tsv, config-dev.txt, config.txt, enclosure.scad]
2026-10-21 English README, ADR 0012, CLAUDE.md rules, banner; consistent spelling
    - README and docs/assets in English, banner tagline "Open-source digital
    instrument cluster" and regenerated banner
    - ADR 0012: English repository, bilingual dashboard
    - CLAUDE.md: English everywhere, dashboard texts in both languages through
    tdm-logic i18n, new status markers
    - American spelling across docs, harness labels and schematic notes;
    ADR 0007 renamed to 0007-licenses; exports and screens regenerated
    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
    [enclosure.scad, inputs.kicad_sch, sensor-bracket.scad, tdm-dash.kicad_sch, wheel.kicad_sch]
2026-10-21 Build the backlight class into the kernel for the DPI panel driver
    DRM_PANEL_SIMPLE depends on BACKLIGHT_CLASS_DEVICE, which bcm2711_defconfig
    builds as a module, so the panel driver silently became a module too and
    the image (which loads no modules) would have had no display. Found by the
    kernel configuration check of the OS image workflow.
    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
2026-10-21 UI for other panel sizes and elongated bar displays
    The window now follows the panel: crates/tdm-dash/src/screen.rs picks the
    layout family from the aspect ratio (wide below 2.2:1, bar above), scales
    the UI to cover an 800x480 or 1200x400 canvas and hands the rest of the
    space to the layouts. Glyphs are signed distance fields, so text scales to
    any size; dial faces are drawn at the panel's pixel size.
    - dash.slint: the frame (telltales, strip, banners, service screens)
    stretches to the window; the wide layouts stay on the 800x480 canvas of
    the mock-up, centred; new bar layouts for Classic, Sport and Touring
    - profile: [display] rotation (0/90/180/270, rotate_180 kept), form
    (auto/wide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
2026-10-21 Reference screens for other panel sizes
    800x480 screens regenerated with distance-field glyphs, and new folders
    for 1024x600, 1280x720, 1280x400, 1920x480, 1920x720 and a 400x1280
    panel mounted on its side.
    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
2026-10-21 Document other displays and bar panels
    - ADR 0013: layout families, scale, distance-field glyphs, limits (no
    fail-dark on HDMI panels, no square, round, DSI or portrait panels)
    - manual chapter 09: "Other displays" with the DPI/HDMI changes and the
    new [display] keys; chapters 03 and 11, os/README, design/README,
    README and CLAUDE.md point to it
    - config.txt: commented HDMI alternative
    - profiles: rotation instead of rotate_180, form and scale as comments
    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
    [config-dev.txt, config.txt]
2026-10-21 OS image CI: room for the licence collection
    The release job ran out of disk in legal-info, after a successful build
    and kernel check. Free more of the runner image, put the Buildroot output
    on the runner's second disk (/mnt) when there is one, and print the free
    space after each heavy step.
    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
2026-10-21 Schematic: drawn wires, block diagram, new title block
    The sheets were a netlist in disguise: every pin ended in a short stub and
    a label, so the circuits had to be pieced together by name, labels
    overlapped, two sheets fell off the index page and the title block was
    KiCad's default. The generator now draws the schematic:
    - hardware/kicad/schgen: placement on the 50 mil grid, orthogonal wires,
    junctions, hierarchical ports, module and connector symbols with named
    pins; the drawing is normalised the way KiCad 9 reads it and checked
    against the declared netlist (no wire may connect anything else)
    - hardware/kicad/sheets: one module per sheet, laid out left to right
    from the bike to th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
    [analog.kicad_sch, backlight.kicad_sch, inputs.kicad_sch, leds.kicad_sch, mcu.kicad_sch, power.kicad_sch, tach.kicad_sch, tdm-dash.kicad_sch]
2026-10-21 Dev image: 512 MB root filesystem; clearer failure report
    The development image (kernel modules, Wi-Fi firmware, SSH, strace) no
    longer fits the 256 MB ext4 root filesystem: the build stopped while
    writing rootfs.ext2. The failure report now puts the error lines first,
    since annotations are cut at a few KB.
    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
2026-10-21 Schematic: backlight breakout off the board, harness fuse, micro-USB plug
    The perfboard has no room for the TPS61169 breakout, and the build steps
    already wired it off the board: J701 now gives it +5 V, CTRL and ground,
    and its output goes to the panel LED pins (J704), in a dashed box like the
    buttons. F101 is marked as the inline fuse of the adapter harness, J401 as
    the terminal for the sensor cable, and J703 has the five pins of the
    micro-USB plug, with ID tied to ground.
    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
    [backlight.kicad_sch, inputs.kicad_sch, power.kicad_sch, tdm-dash.kicad_sch, wheel.kicad_sch]
2026-10-21 Harnesses: schematic designators, compact layout
    Plugs P101 and P102 mate J101 and J102, board terminals and pads use their
    schematic names (J401, J702, J703), and the backlight harness follows the
    breakout off the board. Shorter labels and notes, no repeated pin counts,
    and columns 1 inch apart instead of 2: the backlight drawing goes from
    2525 x 153 pt to 1833 x 234 pt.
    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
    [backlight.bom.tsv, bike-adapter.bom.tsv, panel.bom.tsv, pi.bom.tsv, wheel-sensor.bom.tsv]
2026-10-21 Enclosure renders: no z-fighting, views from above, exploded view
    The active area of the display preview was semi-transparent and coplanar
    with the module: it is now opaque and 0.05 mm proud. The cameras turned
    about the view axis, tilting the pictures; they now turn about Y and X.
    New exploded view; the open shell is drawn in the shell color. The 3D
    preview of the bracket gives way to its dimensioned drawing.
    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
    [enclosure.scad]
2026-10-21 Dimensioned drawings: bracket 1:1, enclosure 1:2, perfboard 2:1
    hardware/drawings/ writes A4 sheets with the frame and title block of the
    schematic, as SVG for the manual and PDF to print at 100 % (each with a
    50 mm bar to check the scale). Every value is read from the .scad files,
    and [TO VERIFY] values, with those computed from them, are orange.
    - bracket: the OpenSCAD outline at 1:1 with hole, pitch, reach, angle and
    slot dimensions, an edge view and center lines to punch
    - enclosure: front, right side, bottom and back with the bike mount points
    - perfboard (replaces hardware/perfboard/): the zone plan on the real hole
    grid with column and row coordinates, Pico header pins and USB en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
2026-10-21 Docs: drawn schematic, dimensioned drawings, harness names
    Chapter 04 explains the drawn schematic and its checks, how to read the
    sheets and the block diagram; chapters 05-07 follow the new designators,
    the backlight wiring and the drawings. hardware/README.md and CLAUDE.md
    describe the sheet modules, the drawing rules and the drawings.
    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
2026-10-21 Enclosure: thin display unit and a small pod for the boards
    The single 182 x 121 x 57 mm block becomes a dashboard in the style of the
    aftermarket TFT units: a 213.8 x 130.8 x 14.5 mm display unit (bezel with
    button wings and lower chamfers, plus a thin cover) and a 109 x 89 x 51 mm
    pod behind its lower half for the perfboard. The Pi Zero 2 W with the
    Kippah and the TPS61169 sit on the cover, inside the pod. The two 12 mm
    IP67 buttons move to the wings of the bezel; their wires and the light
    sensor's run in the hollow rim to a hole that opens into the pod. The bike
    mount uses three lugs on the pod. No sun visor.
    The .scad file asserts that the panel, buttons, pod, FFC slot and board
    stack f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
    [enclosure-cover.stl, enclosure-front.stl, enclosure-rear.stl, enclosure-visor.stl, enclosure.scad]
2026-10-21 Bike mount: an aluminum plate onto the grommets of the original cluster
    The original cluster sits on two M6 studs in rubber grommets on the
    fairing stay, which is bolted to the frame and does not turn with the
    handlebar. The dashboard now goes there: an aluminum plate screwed to
    the three lugs of the pod carries two M6 screws in place of those studs,
    with the original collars, washers and nuts. Only the plate depends on
    the bike, so the printed parts no longer wait for its measurements.
    - enclosure.scad: Bike mount section (stud pitch and position, grommet
    and collar marked [TO VERIFY]), parts mount and mount_2d, the plate
    and screws in the previews, checks for M6 heads against the pod,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
    [dash-mount.dxf, dash-mount.stl, enclosure.scad]
